tatzelbrumm/bionicblinkenlights_chipalooza/docs/RUNLOG.md

<!--
SPDX-FileCopyrightText: 2026 Christoph Maier
SPDX-License-Identifier: Apache-2.0
-->
# Run log: Bionic Blinkenlights slot for the Chipalooza sg13cmos5l harness

Cloud session, 2026-11-08 / 09 (times UTC, taken from the session transcript). Repositories: this one
(`/home/user/bionicblinkenlights_chipalooza`, branch `main`), the harness `tatzelbrumm/sg13cmos5l_ocd_chipalooza`
(read only, `/home/user/sg13cmos5l_ocd_chipalooza`), `tatzelbrumm/claude-cloud-config` (environment, read only).
Scratch work in the session scratchpad (not committed); `S` below is that scratchpad.

## Tool versions (once)

| tool | version |
|---|---|
| ngspice | ngspice-47 (`/foss/tools`, claude-cloud-config archive) |
| xschem | 3.4.8RC |
| KLayout | 0.30.12 (Debian package and Python module) |
| klayout-pex | 0.6.8 (2.5D engine) |
| magic / netgen | 8.3.685 / 1.5.324 (not used for the checks) |
| PDK | `/foss/pdks/ihp-sg13cmos5l` (IHP-Open-PDK iic-jku fork `df4c5054`), OSDI models of the archive |
| Python | 3.13 (`psutil` installed for the PDK PCell library) |

## Steps

| # | time | cwd | command / action | exit | log / output | result |
|---|---|---|---|---|---|---|
| 1 | 21:56 | `/foss` | read `/foss/setup.log` | 0 | — | setup script stopped after `APT_OK`: no `PIP_OK`, `OSDI_OK`, `CACE_OK`, `SETUP_DONE` |
| 2 | 21:57 | `/` | the missing steps of `setup-cloud.sh` by hand: OSDI copy, tool symlinks, `pip install klayout==0.30.12 klayout-pex==0.6.8`, kpex wrapper | 0 | — | tools on `PATH`; CACE not installed (not used) |
| 3 | 21:57 | harness | read `README`, `config.txt`, `gds/slot*_wrapper.gds` | 0 | — | slot 537.15 x 273 um; shared pins identical in all 18 wrappers; 2-pad slots 1, 2, 3, 6, 7, 12, 13, 16, 17, 18 |
| 4 | 21:58 | — | fetch `cmucsd.bitbucket.io` (agent, then `curl`) | fail | proxy 403 | host not in the environment's allowlist |
| 5 | 21:58 | — | environment `sg13cmos5l`: host `cmucsd.bitbucket.io` added (`update_environment`, approved) | 0 | — | — |
| 6 | 21:59 | `S/bb` | `curl` index, img7, img8, img11, img12, `spike1.asc`, PNGs | 0 | — | Q1..Q4 2N3904/2N3906, R1 330, R2 10k, R3 100k, R4 10k, R5 33k, C1 100u, C2 2u, Vdd 3 V |
| 7 | 21:59 | harness | `verilog/rtl/chipalooza_frame.v`: analog bus, bias and switch wiring | 0 | — | buses: per-slot switches to the shared pads |
| 8 | 21:59–22:01 | — | questions to Christoph; answers: generic 2-pad slot and a no-pad variant, coupling digital and analog, LED amplifier off chip, 3.3 V devices; later: self-biased minimal neurons, fast spikes fine | — | — | — |
| 9 | 22:01–22:08 | `S` | read the conventions of `sg13cmos5l_cm_slot7`, `sg13cmos5l_cm_ip__single2diff2single` (`CLAUDE.md`, `docs/traps.md`, `docs/record-keeping.md`), notes branch `sudel_buecher` (`verbatim-chatlog-export.md`, `chatlog_tools/`); skill `xschem-analog-schematic` loaded | 0 | — | record keeping and LVS conventions taken over |
| 10 | 22:07 | `S/sim` | ngspice: HV Vgs = 0 leakage, gate capacitance | 0 | — | 3..60 fA/um (L 10..0.45 um); 4.4 fF/um2 in inversion |
| 11 | 22:11 | `S/sim/n1` | neuron v0 (bias-current stand-ins) | 0 | `neuron_v0.sp` | oscillates, 7 Hz; spike < 1 ms |
| 12 | 22:14 | `S/sim/n1` | neuron v1 (slow node from a 1 nA bias) | 0 | `v1.png` | latches: slow node stuck at 3.25 V |
| 13 | 22:15 | `S/sim/n1` | `dc_dev.py`: subthreshold mirror ratios vs W, L | 0 | — | NMOS 0.8..1.8x, PMOS 0.9..2.4x of the W/L ratio; v1 resized: 2.3 Hz/nA, spike 8 ms |
| 14 | 22:18 | `S/sim/n1` | `tbb.py`: beta-multiplier reference, start-up, enable | 0 | — | starts from leakage in 9 ms; disabled 2 pA |
| 15 | 22:19–22:21 | `testbenches/ngspice` | first `bbl.spice`; `t_first.py` | 0 | `out/first.*` | all four fire; static 117 nA |
| 16 | 22:22–22:26 | `S/sim/n1` | minimal neuron: R1, R5 PMOS gate on vss, R2 NMOS gate on vdd, R4 merged into M3, only R3 biased | 0 | `run4.py`, `v4_zoom.png` | 1.72 Hz/nA, spike 5 us; 20 pF on the membrane halves f |
| 17 | 22:27 | repo | `bbl.spice` rewritten (minimal neuron, DAC, gap junctions, pulse synapses, bias) | — | — | — |
| 18 | 22:28–22:29 | `layout/scripts` | PDK PCells in the KLayout Python module (`pdk.py`: `pya` shim, `psutil`) | 0 | — | `SG13_dev`: nmosHV, pmosHV, rhigh, ptap1, ntap1, ... |
| 19 | 22:30–22:39 | `testbenches/ngspice` | tuning runs; "timestep too small"; stale `.dat` reread (fixed: outputs deleted before each run); `uic` replaced by a 100 us supply ramp | abort | `out/tune_*.log` | — |
| 20 | 22:31–22:58 | `testbenches/ngspice` | option matrices (reltol, gmin, trtol, itl4, rshunt, method), bisection by subcircuit | mixed | `S/tb_debug/` | the pulse synapses (floating nodes kicked by out) trigger the aborts |
| 21 | 22:37 | `testbenches/ngspice` | synapse internal nodes during a spike | 0 | — | floating synapse node bootstraps to 4.4 V and kicks the presynaptic out: real design flaw |
| 22 | 23:04 | repo | synapse rewritten (3.3 V NAND of spk and en drives one long PMOS into the membrane); 2.2 pF on vcpla, vcplb | 0 | `out/bis2_*` | full core converges at 0.1 ms steps |
| 23 | 23:07–23:10 | repo | layout-friendly sizing (ng instead of m, DAC on a 2.5 nA reference, C1 10 pF, rhigh meander) | — | — | — |
| 24 | 23:09–23:20 | `testbenches/ngspice` | leak resistors, cshunt, 10 us steps | mixed | — | only a 10 us max step converges (10 min per 3 s) |
| 25 | 23:11–23:17 | repo | `lay.py`, `build.py`; DRC per cell (`verification/drc/run_drc_cells.sh`) | 0 | `S/drc_*` | first run: off-grid taps, M1.d, M3.d; after fixes all 9 cells 0 violations |
| 26 | 23:19–23:20 | repo | LVS `bbl_unit` (`run_lvs.py --run_mode=deep`); `mkcdl.py` (X -> M/R); `--disable_tap_extraction` | fail, 0 | `S/lvs_unit` | vdd/vss short (rail stubs at the same x) fixed; schematic not read as X lines (CDL needed); then match |
| 27 | 23:21–23:27 | repo | `build_slot.py` (frame `slot1_wrapper.gds`, trunk band, Metal4 columns, TopMetal1 straps); LVS both slots | fail, 0 | `S/lvs_*` | rhigh `l` (41.055 um) and `ps` (0.18 um) to the CDL; then both match |
| 28 | 23:27 | repo | DRC both slots | 0 | `S/drc_slot` | 0 violations, 0 exceptions |
| 29 | 23:28 | repo | branch `main` created, commit `6c9a972`, `git push -u origin main` | 0 | — | — |
| 30 | 23:29–23:31 | repo | kpex 2.5D (`--mode CC`) both slots | 0 | `netlist/pex/` | about 2250 coupling capacitors each, 1 min per slot |
| 31 | 23:36–23:41 | `schematic/xschem` | `gen_sheets.py`, `check_sheets.py` (xschem netlist vs source, device by device) | 0 | `netlist_check/` | stub collisions and a bias short found and fixed (vertical occupancy routing); 0 mismatches in 11 sheets; testbench sheet |
| 32 | 23:39–23:46 | `testbenches/ngspice` | campaign: aborts at the reset of a bus-coupled neuron | abort | `out/sch/*.log` | minimal repro (one neuron + pass gate + bus) runs clean |
| 33 | 23:46 | repo | `build_slot.py <harness>/gds <out> 18 pads`, `mkcdl.py --slot 18 pads`, LVS | 0 | `S/slotN` | slot_18 match |
| 34 | 23:49 | `testbenches/ngspice` | internal nodes during a spike of N0 | 0 | — | N1 jumps 0.07 -> 1.6 V in one 90 ns step: spurious solution of the regenerative loop |
| 35 | 23:51 | repo | commit `941e790` (sheets, PEX, slot_N), push | 0 | — | — |
| 36 | 23:51–00:10 | `testbenches/ngspice` | trtol, reltol, 2 us steps, bias decoupling, removal of coupling blocks | 0 | `S/tb_debug/` | with the gap junctions removed the rates are the uncoupled ones; disabled gap junctions (fA) "couple" numerically |
| 37 | 00:10–00:14 | `testbenches/ngspice` | XM3 current-limited (0.3/4 um, R4 back), C2 2.6 pF | 0 | `out/m3*` | N1/N0 1.117 (expected 1.118), N3/N2 1.094 (1.095); bus pulse 2.4 V |
| 38 | 00:18 | repo | netlist and layout updated, layouts rebuilt; LVS both slots; sheets regenerated and checked | 0 | — | match, match; 0 mismatches |
| 39 | 00:18–00:22 | repo | final DRC both slots; kpex both slots | 0 | — | 0 / 0 violations, 0 exceptions; 2245 / 2253 capacitors |
| 40 | 00:18 | `testbenches/ngspice` | `campaign.py --tag sch --jobs 3` (29 cases) | — | `out/sch/` | first results consistent (tuning, 3 / 10 pF bus load) |
| 41 | 00:22 | `testbenches/ngspice` | `campaign.py --include netlist/pex/bbl_slot_pads.pex.spice --tag pex --jobs 1 --tstop 1.5` (12 cases) | — | `out/pex/` | tune_0_1_2_3: 1.52, 2.06, 2.98 Hz (schematic 1.58, 2.14, 3.07) |
| 42 | 00:24 | repo | commit `52a174b` (current-limited M3, reports, README, run log), push | 0 | — | — |
| 43 | 00:44 | `testbenches/ngspice` | busload_30p: N2, N3 stuck at vm 0.7 V, out 2.5 V | — | `out/sch/busload_30p.dat` | with the current-limited M3 the upstroke is slow, and the reset path (slow follows out) engages at the same out level: a stable intermediate state. Both campaigns stopped |
| 44 | 00:45–00:50 | `S/sim/n1` | `run7.py`: M4, R2 sizes vs bus load 3 / 33 / 103 pF | 0 | — | strong R2: no stuck state but incomplete resets (f does not scale with C); no size fixes it |
| 45 | 00:50 | `S/sim/n1` | `run8.py`: R5 split (XMR5A nmos 0.3/100 gate vdd: fast discharge; XMR5B pmos 0.3/4 gate vin: slow recharge = refractory time) | 0 | — | complete resets at every load; 10 nA: 21.25 / 6.48 / 2.47 Hz for 3 / 33 / 103 pF (1/C prediction 6.42, 2.44) |
| 46 | 00:52 | repo | netlist, layout, sheets updated; slots rebuilt; LVS both; `check_sheets.py` | 0 | — | match, match; 0 mismatches |
| 47 | 00:53 | `testbenches/ngspice` | `campaign.py --tag sch --jobs 3` (30 cases, with tune_low 5 s) | — | `out/sch/` | see SUMMARY |
| 48 | 00:54 | repo | final DRC and kpex both slots, then the post-layout campaign (12 cases, 1.5 s) | — | `verification/`, `out/pex/` | see SUMMARY |
| 49 | 01:00 | repo | commit `746af5a` (R5 split, final DRC/LVS/PEX), push | 0 | — | — |
| 50 | 01:03 | `schematic/xschem` | agent started (Christoph's question): hand-redraw of the leaf sheets with the skill `xschem-analog-schematic`, checks `check_sheets.py` and `sheet_equiv.py` | — | — | see below |
| 51 | 01:18 | `testbenches/ngspice` | campaign results (9 cases): code 1..13 1.56..15.49 Hz unloaded; code 0 fires every 3 s (0.3 Hz); code 15 about 18 Hz | — | `out/sch/` | below the 1..20 Hz spec at both ends |
| 52 | 01:19 | repo | recalibration: XMLP 0.3/8 -> 0.3/7 (DAC reference +14 %), XMH 0.3/9 -> 0.3/3.2 (base leg 0.75 unit); layouts rebuilt; LVS both | 0 | — | match, match; campaigns restarted (`--tag sch --jobs 3`; DRC, kpex, then `--tag pex`) |
| 53 | 01:03–01:37 | `schematic/xschem` | agent (step 50) done: `bbl_neuron` (laid out like spike1.asc, original part names tagged), `bbl_syn`, `bbl_bias`, `bbl_dac`, `bbl_gap` redrawn by hand; `check_sheets.py` OK for all 11 sheets; `sheet_equiv.py` (Christoph's) equivalent for all 10 compared sheets once the reference carries the two new sizes of step 52; placement scripts in `S/hand/` (not committed); `gen_sheets.py` now skips the hand-drawn sheets | 0 | `S/sheets_ref`, `S/sheets_ref_sized` | renders in `schematic/png/` |
| 54 | 01:40 | — | Christoph away; the remaining steps run unattended in `S/finish.sh` (one approval): wait for the campaigns, plots, sheet check, chat log, commits and pushes every 2 min | — | `S/finish.log` | — |
| 55 | 01:47–01:58 | — | approval prompts: the session has no Bash allow rules (only `Skill`, from the launcher); cloud sessions do not read `~/.claude/settings.json`, and a repo's `.claude/settings.json` only in a session with one repository; prompts came from commands with variables, loops and multi-line quoted messages. `S/finish.sh` stopped; from here on single-line literal commands, commit messages from a file (`git -C <repo> commit -F`) | 0 | — | commit and push ran without a prompt; the campaigns kept running |
| 56 | 01:59 | repo | `check_sheets.py` | 0 | `testbenches/ngspice/results/check_sheets.txt` | 11 sheets, 0 mismatches |
| 57 | 02:00 | `verification/pex` | kpex's built-in LVS reports "Netlists don't match": it extracts the taps as devices (layout 451, schematic 68). The PDK LVS with `--disable_tap_extraction` matches both slots. The extracted netlists keep the taps as `ntap1`/`ptap1` subcircuits, defined in the PDK's `resistors_mod.lib` | — | `netlist/pex/` | open point |
| 58 | 02:00 | `testbenches/ngspice` | post-layout `tune_0_1_2_3`: N0 (code 0) fires once, at 0.875 s, within the 1.5 s run, so no frequency (reported 0); N1..N3 2.50 / 2.95 / 3.98 Hz, 3..4 % below the schematic (2.60 / 3.06 / 4.12) | — | `out/pex/` | the 1.5 s post-layout runs resolve 1.3 Hz and up |
| 59 | 02:02–02:05 | — | both campaigns stopped: they ran detached from any tracked task; with the finish script and the watchers stopped, the idle session's container was restarted and the processes were lost (11 / 30 schematic and 3 / 12 post-layout cases had finished; their results are kept) | — | — | noticed at 03:20 |
| 60 | 03:21 | `testbenches/ngspice` | the 28 remaining cases restarted as three tracked background tasks (2 h limit each): post-layout 9 cases `--jobs 2`; schematic 7 + 7 cases `--jobs 1` each; the last 5 (`gap_both_v0.6`, `gap_both_v0.9`, `mutual_*`) follow | — | `out/sch/`, `out/pex/` | logs appended |
| 61 | 04:10–04:43 | `testbenches/ngspice` | all cases done: schematic 30, post-layout 12 | 0 | `out/sch/`, `out/pex/` | — |
| 62 | 04:45–04:58 | `testbenches/ngspice` | post-layout `busload_30p`, `busload_100p`: N2, N3 reported 0 Hz. The pulse of a bus-coupled membrane on a loaded bus peaks at 1.16 V (30 pF) and 0.90 V (100 pF), below the 1.5 V level the bus detector used. `bbltb.bus_spikes` now takes the fast upstroke (a step faster than 500 V/s followed by a rise of more than 0.15 V within 100 us) and drops the repeated time points of `wrdata`; `campaign.py --reanalyze` recomputes the results from the saved waveforms | 0 | `out/pex/*.json`, `out/sch/*.json`, `out/reanalyze_sch.log` | post-layout 30 pF: 2.18 Hz (schematic 2.19); all other values unchanged. Schematic: bus detector equal to the internal-node detector in every case except `vcplb` 0.0 / 0.8 / 1.2 V, where the pass gate keeps the spike off the bus (N2, N3 still slowed by the bus capacitance: 2.95 / 2.21 Hz at 0.8 / 1.2 V) |
| 63 | 04:50 | `testbenches/ngspice` | post-layout `busload_100p` and `tune_low` re-simulated for 4 s (one spike only in 1.5 s at 0.8 to 1.2 Hz) | — | `out/pex/` | below |
| 64 | 04:50–05:02 | `testbenches/ngspice` | coupling results; gap junction swept further (`gap_both_v0.3/0.4/0.5`, new cases) | 0 | `out/sch/` | pulse synapses: N0 -> N1 strong locks 2:1 (vector strength 0.89); mutual strong locks 1:1 (5.33 / 5.33 Hz, VS 1.00), mutual weak drifts (5.59 / 3.23 Hz). Gap junction N0 <-> N1 (8.0 / 10.6 Hz uncoupled): vcpla 0.3 V no effect, 0.4 V both slow (6.39 / 9.79 Hz, VS 0.31), 0.5 V and above and all digital legs: N0 suppressed. N3 -> bus2: N2 slowed (6.17 -> 2.40 -> 1.31 Hz), no locking. The membranes charge with 4..150 pA; a coupling conductance above about 0.1 nS drains more than that while the other neuron is in reset (ms), and a spike (10 us) is too short to pass charge: electrical coupling acts as inhibition |
| 65 | 05:20 | `testbenches/ngspice` | post-layout `tune_low` (4 s) | 0 | `out/pex/tune_low.json` | code 0: N0, N1 1.14 Hz, N2, N3 0.88 Hz (schematic 1.19 / 0.91) |
| 66 | 04:50–06:07 | `testbenches/ngspice` | post-layout `busload_100p` (4 s): ngspice stopped without output at 06:06, it needed 15 GB for all 2510 nodes over 4 s (7 GB available). `bbltb.run` now saves only the written vectors (`save`); 20 ms smoke test, then the 4 s run again | — | `out/pex/` | below |
| 67 | 06:08 | repo | LVS repeated on `final/gds/bbl_slot_shared.gds`, `bbl_slot_pads.gds` (sha256 equal to `layout/gds/`) | 0 | `S/lvs_final_*` | match, match |
| 68 | 06:09 | repo | chat log built and verified (`build_chatlog.py`, `verify_chatlog.py`) | 0 | `docs/chatlog/` | 166 texts, 0 missing, no reasoning windows found |
| 69 | 06:29–07:30 | `testbenches/ngspice` | post-layout `busload_100p` (4 s, only the written vectors saved) | 0 | `out/pex/busload_100p.json` | N2, N3 0.834 Hz (3 spikes, period 1.199 s; schematic 0.837 Hz); N0, N1 8.99 / 9.00 Hz |
| 70 | 07:30–07:43 | `testbenches/ngspice` | post-layout `busload_10p` (1.5 s), to complete the post-layout bus-capacitance curve | 0 | `out/pex/busload_10p.json`, `results/busload.png`, `results/results.md` | N2, N3 4.02 Hz (schematic 4.09); post-layout exponent over 3 / 13 / 33 / 103 pF: -0.98 (schematic -0.99 / -1.00) |
| 71 | 07:50 | repo | SUMMARY, README and `campaign.py` (`PEX_CASES` with `busload_10p`) updated; chat log rebuilt and verified; final commit | 0 | `docs/` | see the verify counts in the commit's chat log |
| 72 | 10:28–10:35 | repo | slot 3 assigned (Christoph): `build_slot.py <harness>/gds final/gds 3 pads`; `mkcdl.py ... --slot 3 pads`; IHP DRC and LVS on `final/gds/slot_3.gds`. The slot 3 frame has a second `vss_3v3` pin (Metal2, right edge, x 533.15..535.15, y 11.6..71.1; magic port 21 = the TopMetal1 pin; slots 3 and 12 only); in the first build it touched nothing and LVS matched only because KLayout joins equal labels. `build_slot.py` now ties such pins to the nearest ground strap (Via2 + Via3, Metal4 up, TopVia1, strap extended); generic variants rebuilt: XOR 0 against the delivered ones | 0 | `final/gds/slot_3.gds`, `verification/drc/slot_3`, `verification/lvs/slot_3` | DRC 0 violations, LVS match; label-free flood fill from the Metal2 pin reaches the TopMetal1 `vss_3v3` pin |
| 73 | 10:36–10:40 | repo | `build_slot.py` reads the pad types from the harness `config.txt` (the old list allowed slots 6, 7, 13, 17, whose dedicated pads are digital or custom, and missed 5, 9, 10, 14); `bbltb.slot_dut` maps the pins of any slot; generic variants moved out of `final/gds/` (copies in `layout/gds/`, same sha256); README: slot 3 and how to move to another slot | 0 | `layout/scripts/build_slot.py`, `testbenches/ngspice/bbltb.py`, `README.md` | slot 6 refused (pads `IOPadIn`, `IOPadOut16mA`); slot 3 rebuilt: XOR 0 against `final/gds/slot_3.gds` |
| 74 | 10:38–10:45 | `testbenches/harness_bus` | what a slot bus sees in the harness: the harness's extracted `analog_switch_med` (`netlist/layout/chipalooza_frame.spice`, read only) and the PDK `sg13cmos5l_IOPadAnalog`, AC (1 kHz) and DC at 0.3 / 0.8 / 1.5 V, 27 and 60 C. Topology from the harness RTL: per bus, 18 switches (one per slot) on one shared net that is the analog pin | 0 | `testbenches/harness_bus/results.md` | closed switch 1.7..2.4 pF; open switch 0.43 pF (slot side), 0.40 pF (shared side, x 17); pad 0.21 pF. Pad leakage (model) 106 / 187 / 336 pA to ground at 0.3 / 0.8 / 1.5 V (27 C), from the soft-breakdown term of the antenna diode models (`bv` 11.6 V, `nbv` 48.9; "designed for reverse direction"); the clamps alone source 6..27 pA |
| 75 | 10:40–11:05 | `testbenches/harness_bus` | N2, N3 with the pad on `analog_bus2/3` (bus switch closed), schematic, 2.5 s. The full pad model stops the transient at the first reset (antenna diode in forward bias, "Timestep too small"); replaced by its DC I-V as a `pwl` B source plus 0.21 pF (`padiv.py`). First try used `table` (not an ngspice function) and failed; rerun with `pwl` | 0 | `testbenches/harness_bus/padtest_leak.json`, `results.md` | no spike at codes 6 / 10 / 15 (3 pF), code 15 with 10 pF, code 15 at 60 C: membranes settle at 0.09 / 0.25 / 0.51 V, where charging current (about 62 / 97 / 139 pA) = pad leakage. Reference without pad, code 15, 10 pF: 10.46 Hz (1/C law 10.43) |
| 76 | 11:08 | repo | LVS of `slot_3` repeated against the committed `bbl.cdl` (11:02, match); README, SUMMARY; chat log rebuilt and verified; commit | 0 | `docs/` | 193 texts, 0 missing; 4 40-character windows shared with reasoning, all from one sentence of a visible reply (pad leakage "0.1–0.3 nA at 0.3–1.5 V, comparable to or larger than the 4–150 pA that charges the membranes"), no reasoning text in the log |
| 77 | 11:10–11:20 | `S/n3hi` | Christoph: option 2 for N3, "and tolerate that the design makes itself heard (frequency shift to audio range, with the option to detune to blinking frequencies by loading the analog bus with external capacitance)". Trial a: N3 = `bbl_neuron_hi` with XMR3 48/3 x 8 (16 x the DAC current: 5.6 .. 174 nA), XMR5B, XM2 and the pass gate XMP3 scaled | 0 | `S/n3hi/n3a.json` | 3 pF: 674 Hz / 5.5 kHz / 12.7 kHz at codes 0 / 6 / 15; 20 pF with the pad leakage: -2.4 %. 10 nF: no oscillation (membrane held at 0.78 V, 10 uA): with nF on the membrane the regenerative loop through it (XM3) is 1000 x slower than the reset, which then holds the membrane at the threshold |
| 78 | 11:20–11:50 | `S/n3hi` | hysteresis for N3, probed on the internal nodes (`probe.py`): b, c PMOS pull-up on out with gate rst (turns off only at rst about 2.5 V, after XM2 has started the reset); e NMOS pull-up with gate slow; f Schmitt comparator (inverter out -> outb, pull-up XMQ gate outb) with the inverter switching at 1.5 V (too late); g inverter skewed to 2.3 V: flips cleanly, 1 nF resets fully, 10 nF only to 0.63 V (slow recharged through the XMR5A follower within 1 us, rst collapsed); h XMR5A 0.3/100: reset cut short when the internal membrane falls below the release level before the bus | — | `S/n3hi/` | i (below) |
| 79 | 11:50–12:05 | `S/n3hi` | variant i: XMR5A becomes a switch slow -> vss with gate outb (3/0.45): slow empties within ns when out falls and recovers only through XMR5B (10/0.45 x 2), rst fully high for the whole refractory time; XM4 10/0.45, XM2 40/0.45, XMP3 40/0.45, Schmitt XMQ 0.3/3, XMIP 3/0.45, XMIN 0.3/4. N3 spikes counted from membrane resets (out only dips for ns) | 0 | `S/n3hi/` | 3 pF: 470 Hz / 3.88 kHz / 8.92 kHz (codes 0 / 6 / 15, CV < 0.4 %); 100 pF code 6: 500 Hz; 1 nF: 55.0 Hz; 10 nF: 0.67 / 5.56 / 12.84 Hz; pad leakage: 20 pF code 0 209 Hz, 10 nF code 6 5.54 Hz (-0.25 %); bus swings 0 .. 0.92 V and resets fully in every case. Harness switch closed: 3.5 .. 17 Ohm (`ron.sp`) |
| 80 | 11:12–12:08 | `layout/`, `schematic/` | `build.py`: `bbl_unit_hi` (sizes table, Schmitt devices, XMR5A terminals), XMP3 40/0.45; stub rule: same-net Metal2 stubs closer than 0.45 um and not coincident gave M2.b / V2.b / V2.a in `bbl_unit_hi`, now kept apart (all other cells XOR 0 against the old ones); `bbl_pass` wider, `bbl_lvinv` / `bbl_tielo` moved 5 um right. `gen_sheets.py`: `bbl_neuron_hi.sch` derived from the hand-drawn `bbl_neuron.sch` (sizes from the netlist, XMR5A rewired, Schmitt devices added on the right), `bbl_unit_hi`; renders | 0 | `layout/gds/`, `final/gds/slot_3.gds`, `schematic/` | `check_sheets.py`: 13 sheets, 0 mismatches |
| 81 | 12:09–12:14 | repo | IHP DRC (no density) and LVS (`--disable_tap_extraction`) on `slot_3`, `bbl_slot_pads`, `bbl_slot_shared`; kpex 2.5D CC on all three | 0 | `verification/`, `netlist/pex/` (new `slot_3.pex.spice`) | DRC 0 / 0 / 0; LVS match x 3; 2288 / 2288 / 2280 coupling capacitors |
| 82 | 12:15 | `testbenches/ngspice` | testbench: harness switch 10 Ohm (was 2 kOhm), N3 spikes from membrane resets (`bbltb.resets`), 10 nF on `analog_bus3` in all system cases (`CBUS`), new N3 cases (`n3_tune_*`, `n3_busload_*` 3 pF .. 100 nF, `n3_blink_*`, `n3_pad_*`); old results moved to `out/*_before_n3hi`; campaigns started: schematic 51 cases `--jobs 3`, post-layout on `slot_3` 20 cases `--tstop 1.5` | — | `out/sch/`, `out/pex/` | rows 83 ff. |
| 83 | 12:15–14:12 | `testbenches/ngspice` | the two campaigns | 0 / killed | `out/sch/`, `out/pex/`, `campaign_*.log` | schematic: 49 of 51 ok; `vcplb_0.0` (at 1.15 s) and `n3_busload_100n` (at 0.97 s) stopped with "Timestep too small, trouble with node bus0", also after the retry at half the step. Post-layout: stopped by the 2 h limit of the background task after 11 of 20 cases; `n3_tune_15` stopped the same way (at 5.4 ms) |
| 84 | 14:13–14:21 | `testbenches/ngspice` | cause: the slot side of the bus switch (`bus0`, an inverter output) had only femtofarads behind 10 Ohm, a time constant of femtoseconds. `bbltb.netlist`: 0.5 pF of the bus capacitance moved to the slot side (`cslot`; the closed switch has 0.45 pF of its own per side, `harness_bus`), the total unchanged. Check, schematic, tag `chk` | 0 | `out/chk/` | `n3_tune_6` 3882.30 Hz (before 3882.74), `n3_tune_15` 8922.90 (8924.50, the run that had not failed in the schematic), `n3_pad_15` 4070.40 (4070.21): at most 0.02 %, so the other results stand. Reruns started: schematic `n3_busload_100n`; post-layout the 9 remaining cases and `n3_tune_15` in two tasks (`--jobs 2`, `--jobs 1`) |
| 85 | 14:13–14:20 | `S`, `out/sch/` | `bus23_weak`: N3 does not fire. Waveforms 1.0 .. 1.1 s | 0 | — | bus3 0.48 .. 0.66 V, bus2 0 .. 2.05 V, N2 33 Hz: the weak leg (0.3/10, about 0.1 MOhm) passes N3's 80 nA (code 7) to bus2, N2 (threshold about 0.66 V) fires first and its resets drain N3 (threshold 0.92 V). The strong leg locks both 1:1 at 8.81 Hz. `vcplb_0.0` (partial waveform, 1.15 s): N3 599 Hz on its own membrane. The 9.32 Hz first read for it came from the old campaign's lines at the top of the appended log |
| 86 | 14:21–14:31 | `S/n3hi` (`iq.py`, `icharge.py`, `idac.py`) | DC sweeps with the membrane held by a source: supply current vs membrane voltage, charging current vs code, DAC diode current (the DAC's vdd pin on its own ammeter). An `op` lands in the reset state (mA into the source); a `dc` sweep from 0.1 V continues on the right branch | 0 | — | N3 charges with 6.06 nA at code 0, 7.44 nA more per step, 117.7 nA at code 15 (not 5.6 .. 174 nA as written since row 77: 15.9 x the DAC's 0.383 .. 7.42 nA); N2 7.7 .. 139 pA (DAC / 50 .. 53, not 1/57). Supply current above the bias: N2 0.2 uA at 0.6 V, 1.2 uA at 0.7 V, then fires; N3 1.2 uA at 0.7 V, 7.2 uA at 0.9 V (the Schmitt trigger holds out up to 0.92 V): the slot's 0.85 .. 1.6 uA in the campaign. Refractory time of N3 from the waveforms (membrane below 20 mV): 190 / 23 / 11 us at codes 0 / 6 / 15, a tenth of the period on the bare bus (README had 0.8 ms .. 8 us) |
| 87 | 14:22–14:28 | `testbenches/ngspice` | cases `n3_c20p_0`, `n3_c20p_15` (20 pF on bus3, no pad), the references for `n3_pad_*` | 0 | `out/sch/` | 214.85 / 4101.45 Hz; with the pad 209.21 / 4070.21 Hz: -2.6 % / -0.76 % |
| 88 | 14:24–14:32 | repo | corrections from rows 85 to 87 in README, `harness_bus/results.md` (N2's threshold about 0.7 V, where the pad sinks 170 pA; "1.6 V" was wrong), comments of `bbl.spice` (N3 currents and refractory time, DAC), sheet note of `bbl_neuron_hi` (XMR5A gate on outb); `gen_sheets.py`, `check_sheets.py`, render; `bbl.cdl` regenerated (diff: comments only) | 0 | `schematic/`, `netlist/` | 13 sheets, 0 mismatches. The README's 10 MOhm probe sentence was wrong (50 nA at 0.5 V, "stops N3 below code 5"): the probe sinks 92 nA at the 0.92 V threshold and stops N3 up to code 11 |
| 89 | 14:32–14:36 | `testbenches/ngspice` | load average 16 to 20 with 4 to 7 ngspice: 8 threads each. `OMP_NUM_THREADS=1` in the testbench environment leaves them at 8 (reverted); the helper threads do work (about 42 s CPU each against 4.3 min for the main thread). The 4 s post-layout `busload_100p` stopped again to keep the other tasks within their 2 h; `bbltb.run` now keeps a failed attempt's log as `.log1` | — | — | — |
| 90 | 14:38–15:06 | `testbenches/ngspice` | the reruns with 0.5 pF on the slot side. `vcplb_0.0` stopped at bus3 (0.25 s) and bus2 (0.049 s); with 2 kOhm and femtofarads (the old model) at bus2 (1.09 s, 0.33 s): with the pass gates off the slot side of the bus floats. `n3_busload_100n` stopped at bus0 (9.1 s); post-layout `busload_10p` at bus0 (0.54 s); `tune_12_13_14_15`, `syn01_both`, `busload_30p`, `bus23_strong` needed retries. New bus model (`bbltb.netlist` defaults): bus2 / bus3 10 Ohm with 0.5 pF on the slot side; bus0 / bus1 (buffered N0 / N1, display only) 2 kOhm with all of C on the bus side, the model of every run before 2026-11-09 (N0 / N1 rates with either: 9.3207 / 9.3192 Hz at code 6, 1.18578 / 1.18575 Hz at code 0). `vcplb_0.0`: 2 kOhm and 0.5 pF on every bus, 1.2 s. The old-model retries of `busload_30p` and `bus23_strong` killed and rerun with the new one | 0 | `out/sch/n3_busload_100n.*` | `n3_busload_100n` (2 kOhm on bus0 / bus1): N3 0.6415 Hz, 15 % above the 1/C line through 10 nF (0.556 Hz): the bus resets only to 0.11 V, because the refractory time (23 us at code 6) is two time constants of 100 nF through about 110 Ohm (pass gate, reset transistor, switch). The README had "resets completely from 3 pF to 100 nF" (also in the message of commit `252bc48`): true up to 10 nF |
| 91 | 15:05–15:28 | `testbenches/ngspice` | more stops with the new bus model: post-layout `busload_10p` at 0.5417 s (with 10 Ohm on bus0 at 0.5415 s: the same instant, one of N3's resets, 0.1819 + 2 x 0.17997 s), so the bus model is not the cause; `vcplb_0.0` with `.option itl4=100` at 0.106 s and 0.493 s. `bbltb.run` keeps the first attempt's waveforms too (`.dat1`); `campaign.py`: when both attempts stop, the rates come from the longer one if it covers at least half of t0 .. tstop (`partial` = where it ends, in the JSON); `--reanalyze` does the same with saved waveforms | 0 | `out/sch/vcplb_0.0.json` | `vcplb_0.0` reanalyzed (partial, 0.1 .. 0.493 s): N0 / N1 / N2 9.32 / 9.34 / 9.33 Hz (N2 on its own membrane), N3 599.2 Hz. Post-layout done: `tune_12_13_14_15`, `syn01_both`, `bus23_off`, `bus23_strong` (8.74 / 8.74 Hz), `n3_tune_15` (8689 Hz), `busload_30p` |
| 92 | 15:15–15:25 | `testbenches/ngspice` | spike intervals of every free-running neuron in every result, flagged where one differs from the median by more than 5 % | 0 | — | 5 spurious early spikes in about 75 runs: post-layout `busload_0p` N0 and N1 together at 1.2953 s (76 ms into a 110 ms ramp; mean rate 9.32 Hz against 9.02 Hz from the median interval), schematic `tune_8_9_10_11` N0 (2.3452 s), `n3_busload_100n` N0 (9.2129 s), `syn01_none` N1 (2.2737 s); plus a short first interval after t0 in `n3_c20p_15` / `n3_pad_15` (start-up, both alike). `plots.py`: rates of free-running neurons (tuning, bus load, N3 tables and figures) = 1 / median interval; the coupling cases keep the mean rate |
| 93 | 15:26–15:27 | repo | IHP LVS (deep, `--disable_tap_extraction`) of `slot_3`, `bbl_slot_pads`, `bbl_slot_shared` against the regenerated `bbl.cdl`; the 12:10 run logs removed (the other files of those directories were overwritten) | 0 | `verification/lvs/` | match x 3, 0 errors |
| 94 | 15:28–15:54 | `testbenches/ngspice`, `S/slot3` | post-layout `busload_10p` stopped in both attempts (retry at 1.219 s): reanalyzed as partial (0.3 .. 1.219 s); `gap_off`, `gap_both` done. XOR of `slot_3` against `bbl_slot_pads` repeated on the current layouts (`xor_slot.py`) | 0 | `out/pex/` | N2 4.01 Hz at 13 pF (schematic 4.09); gap off 7.70 / 10.26 Hz, both legs N0 fewer than 2 spikes in 1.5 s, N1 9.08 Hz. XOR: Metal2 and its pin layer (the `vss_3v3` pin), Via2 .. TopVia1 (the via stack), 67/23 (slot 1's no-fill box), labels `s3_*` / `s1_*`, `vss_3v3`; nothing else |
| 95 | 15:56–16:02 | repo | post-layout `busload_100p` (4 s) done; `plots.py sch pex` (post-layout points without connecting lines where they are sparse); README, SUMMARY (rewritten for N3, sha256 of the delivered files), `harness_bus/results.md`; chat log rebuilt and verified; commit, push | 0 | `testbenches/ngspice/results/`, `docs/` | N2 0.833 Hz at 103 pF (schematic 0.837), post-layout exponent -0.98. Chat log: 290 texts, 0 missing; 5 40-character windows shared with reasoning, all in visible replies (the pad-leakage sentence of row 76, and "I've stopped the 4 s run and will restart it when cores free up"), no reasoning text in the log |
