tatzelbrumm/bionicblinkenlights_chipalooza/render/bbl_slot_pads.png

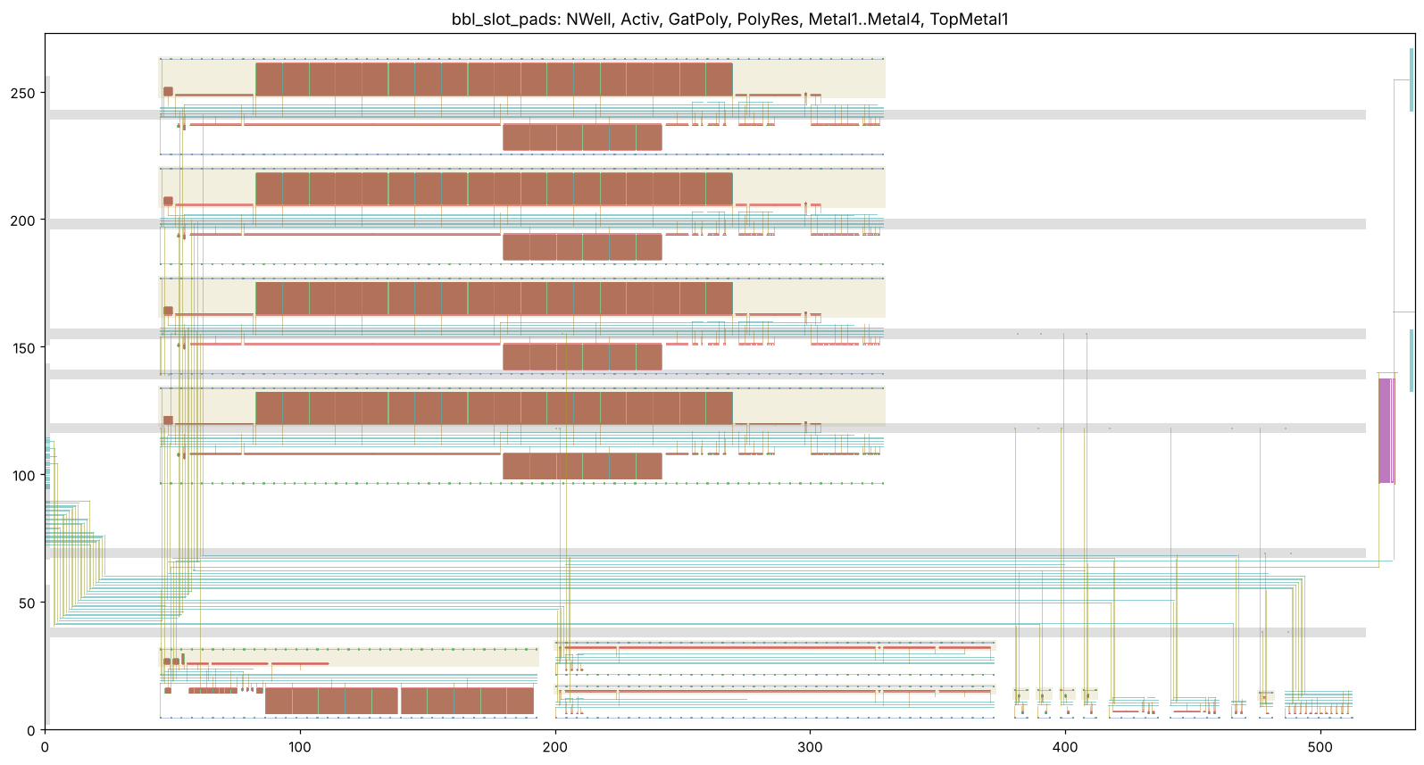
render/bbl_slot_pads.png
