tatzelbrumm/bionicblinkenlights_chipalooza/render/bbl_unit.png

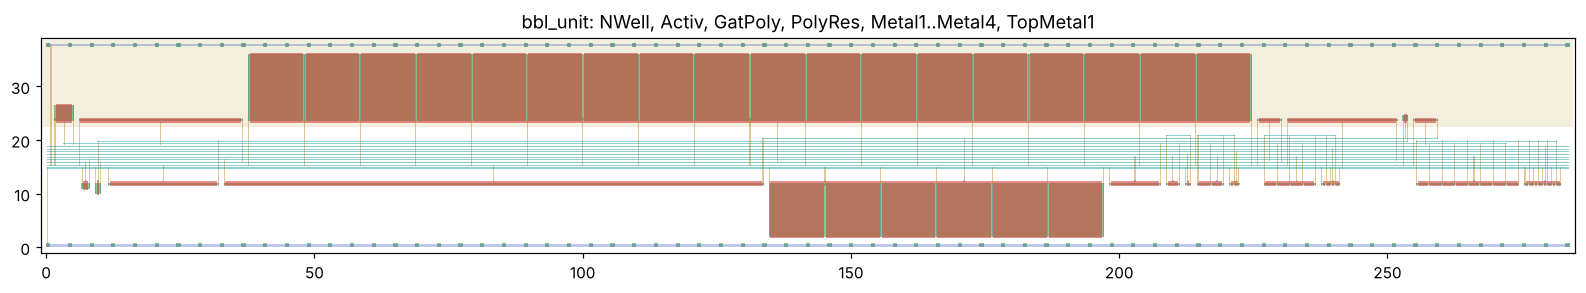
render/bbl_unit.png
