tatzelbrumm/bionicblinkenlights_chipalooza/schematic/png/bbl_bias.png

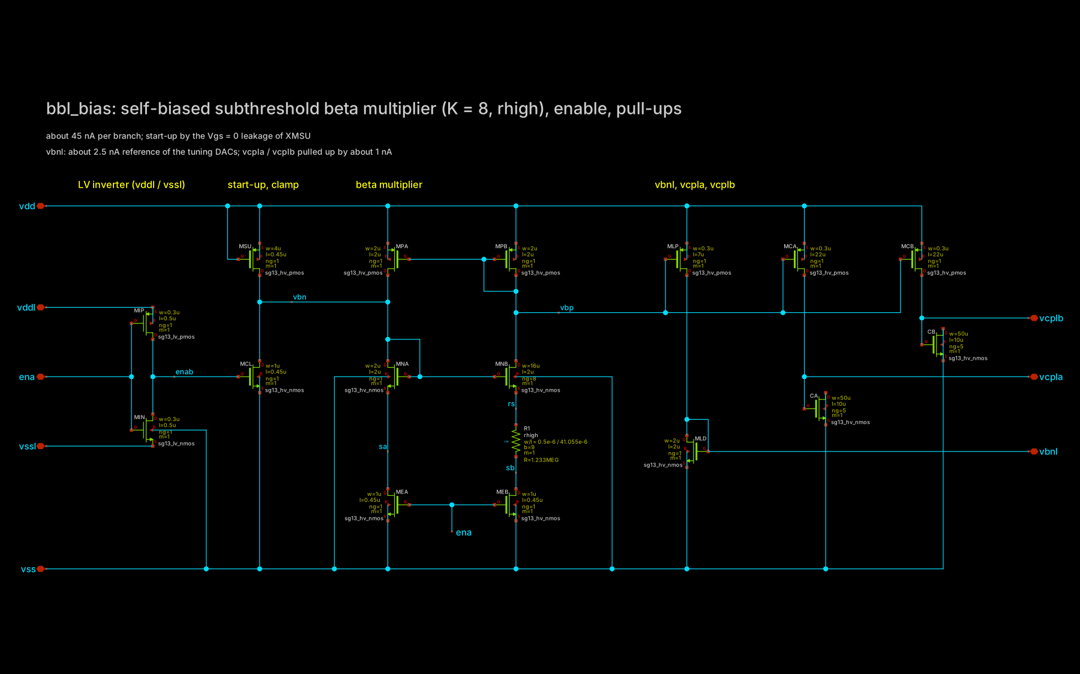
schematic/png/bbl_bias.png
