tatzelbrumm/bionicblinkenlights_chipalooza/schematic/png/bbl_core.png

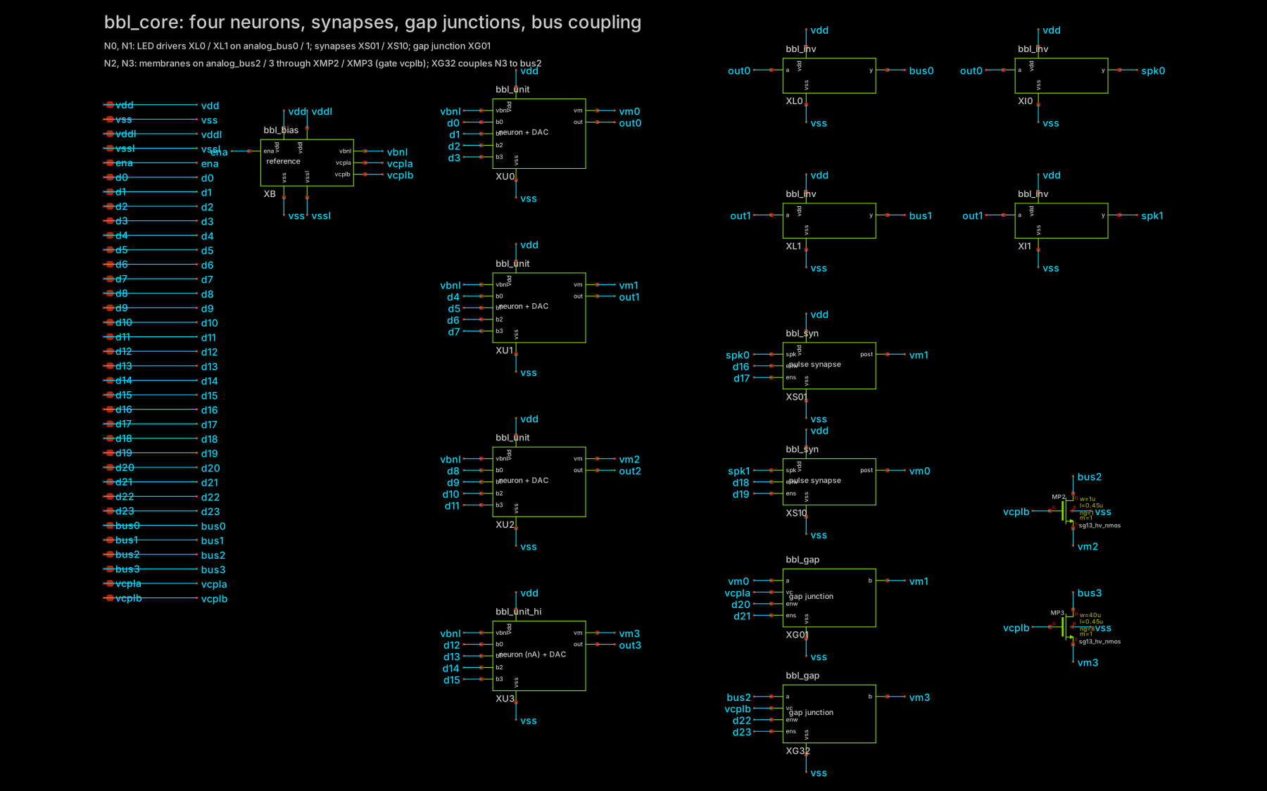
schematic/png/bbl_core.png
