tatzelbrumm/bionicblinkenlights_chipalooza/schematic/png/bbl_dac.png

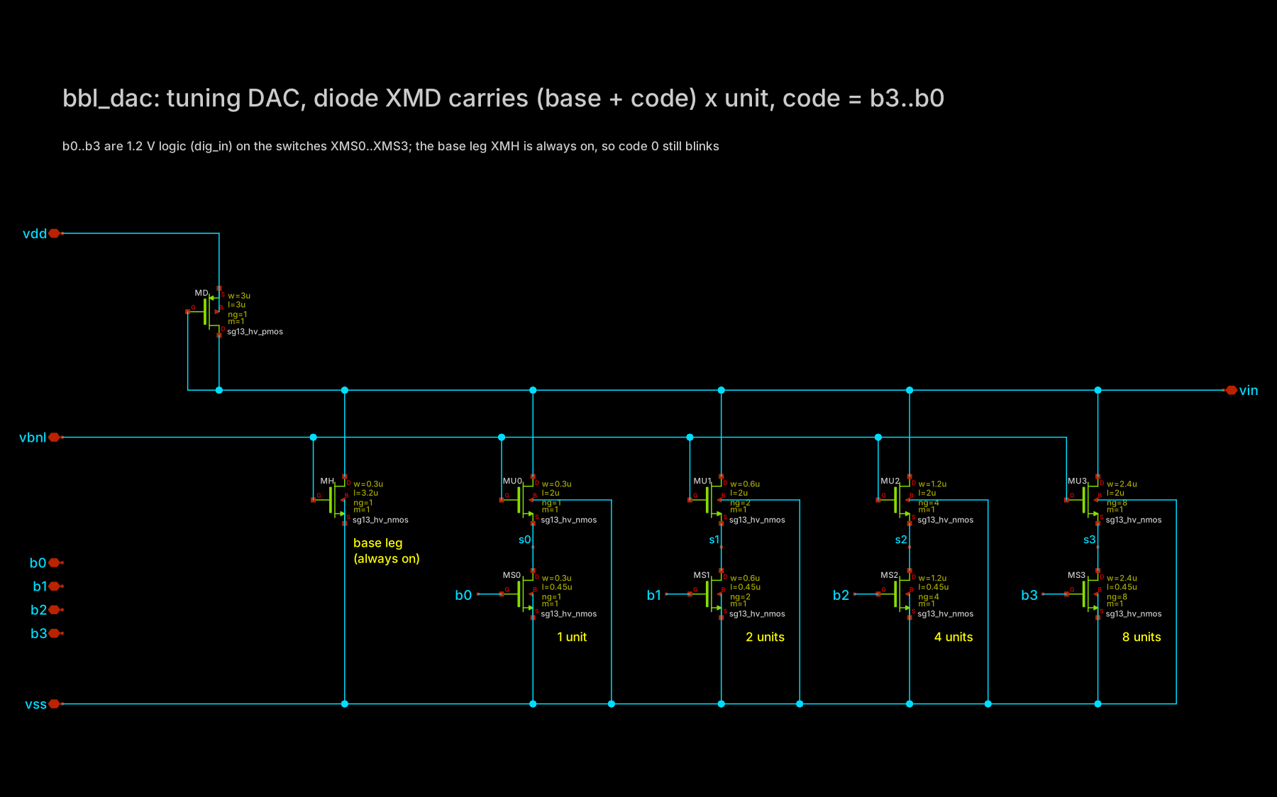
schematic/png/bbl_dac.png
