tatzelbrumm/bionicblinkenlights_chipalooza/schematic/png/bbl_gap.png

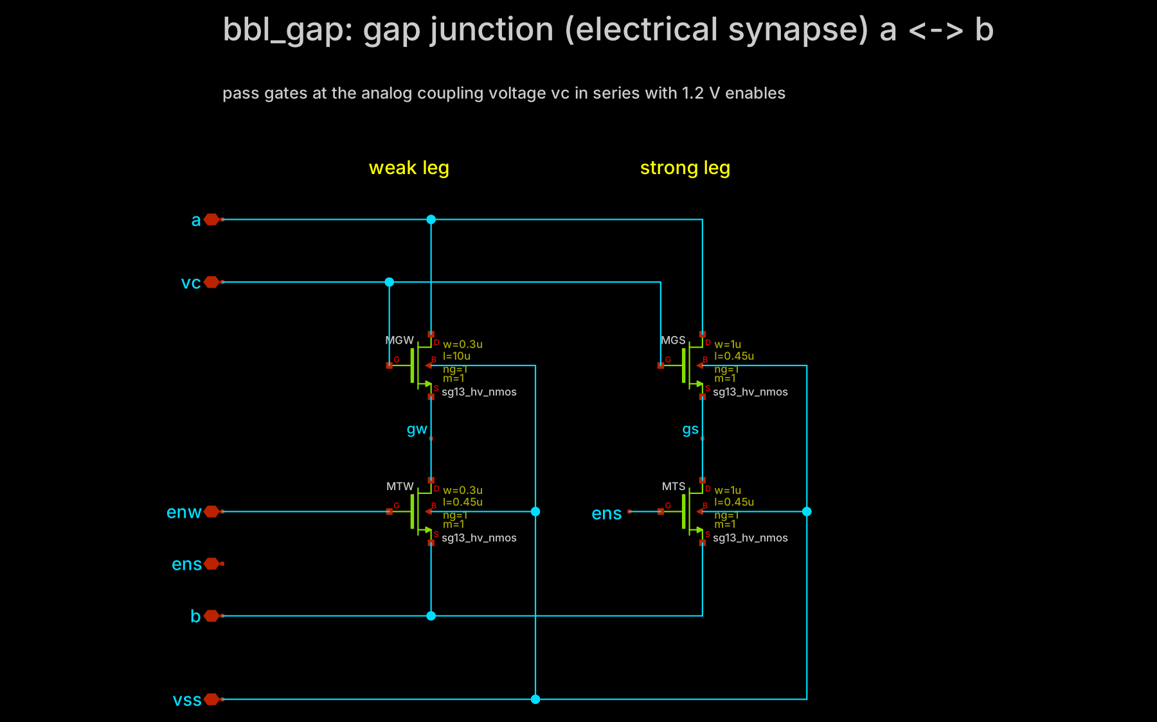
schematic/png/bbl_gap.png
