tatzelbrumm/bionicblinkenlights_chipalooza/schematic/png/bbl_inv.png

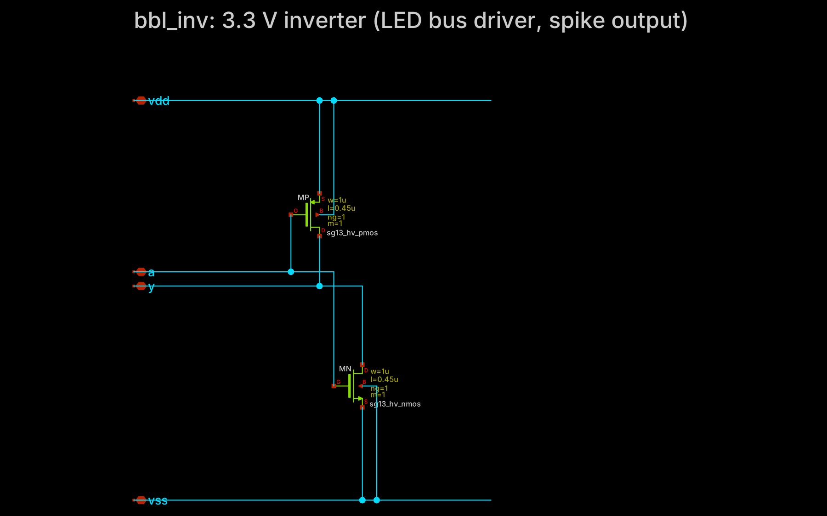
schematic/png/bbl_inv.png
