tatzelbrumm/bionicblinkenlights_chipalooza/schematic/png/bbl_neuron.png

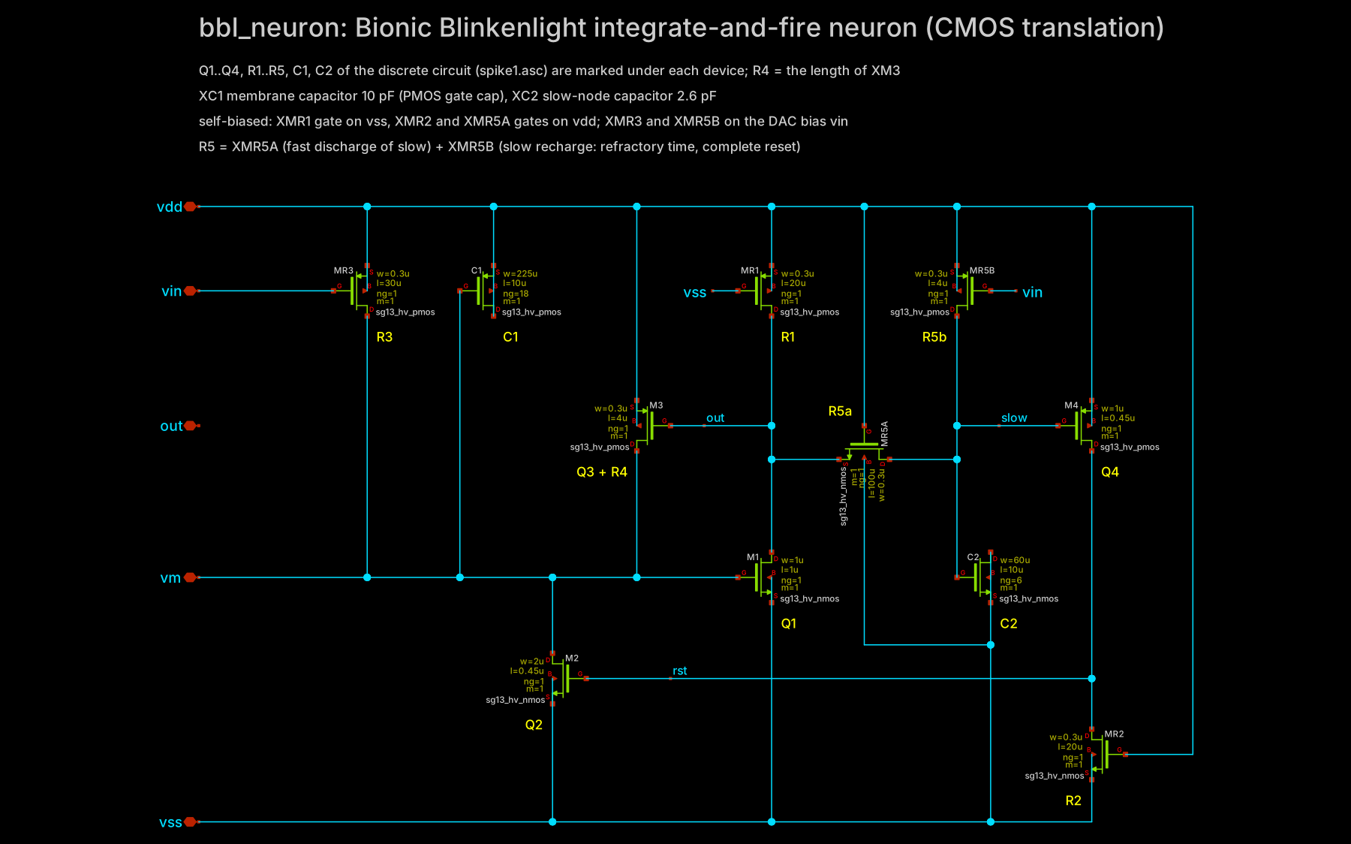
schematic/png/bbl_neuron.png
