tatzelbrumm/bionicblinkenlights_chipalooza/schematic/png/bbl_neuron_hi.png

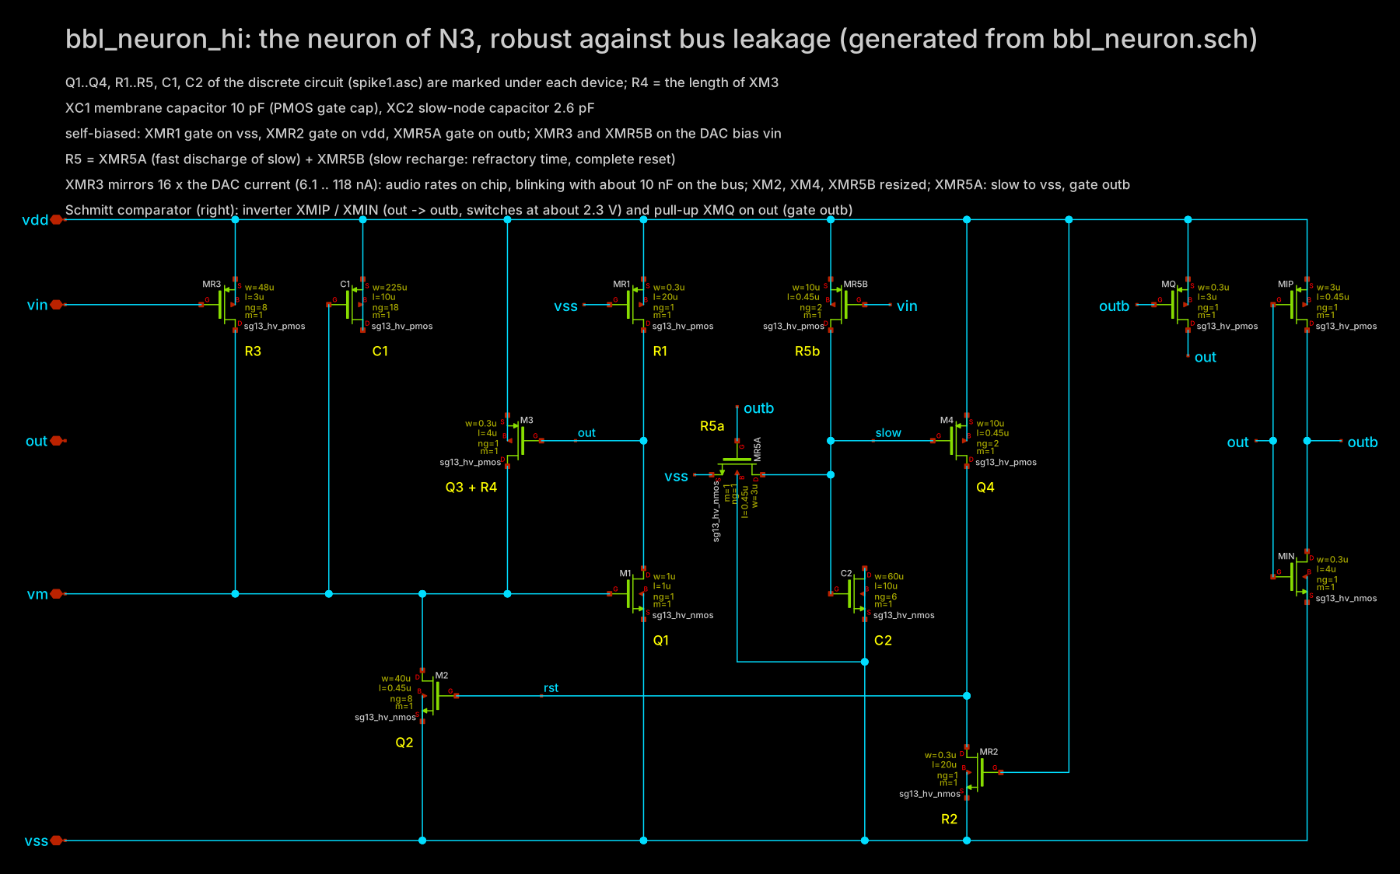
schematic/png/bbl_neuron_hi.png
