tatzelbrumm/bionicblinkenlights_chipalooza/schematic/png/bbl_slot_pads.png

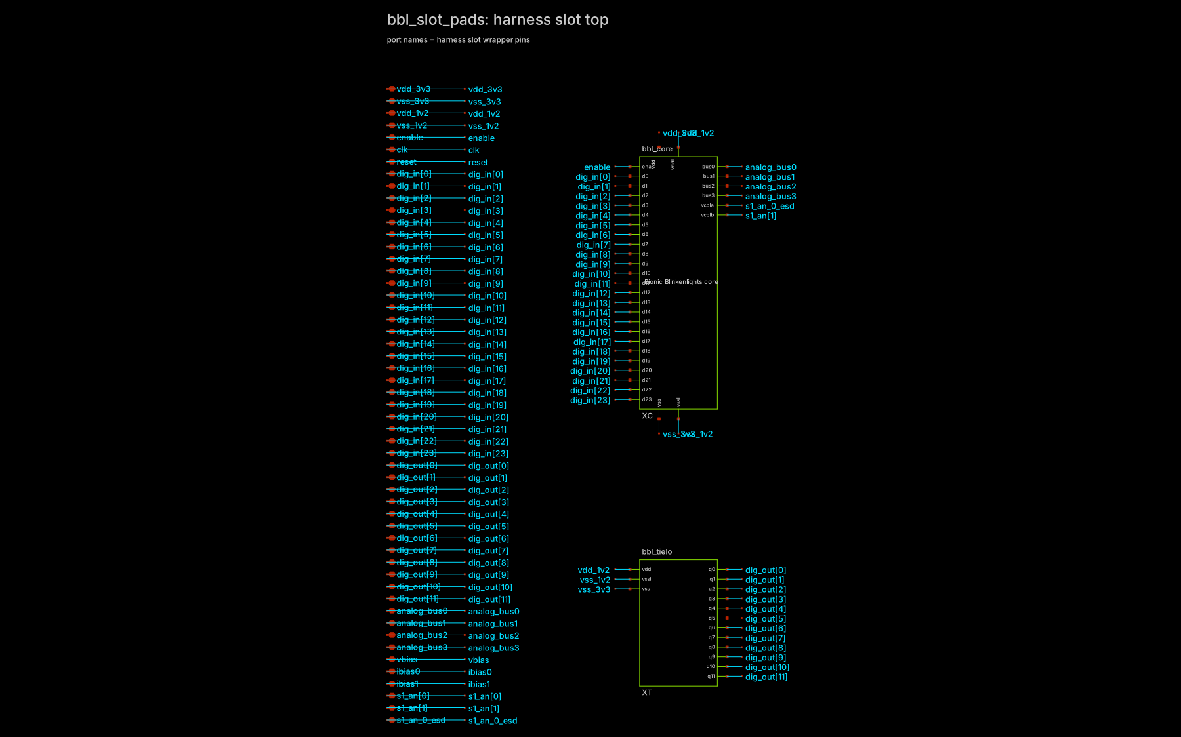
schematic/png/bbl_slot_pads.png
