tatzelbrumm/bionicblinkenlights_chipalooza/schematic/png/bbl_syn.png

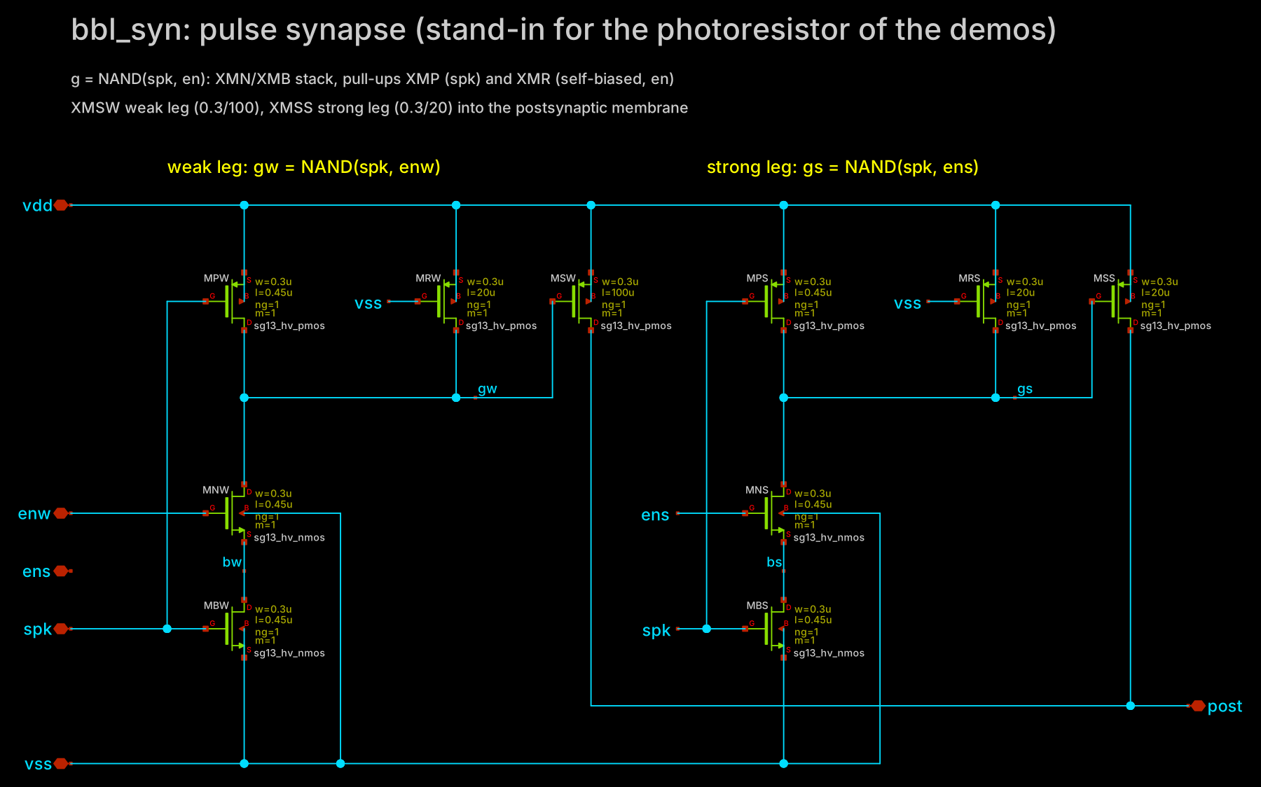
schematic/png/bbl_syn.png
