tatzelbrumm/bionicblinkenlights_chipalooza/schematic/png/bbl_tielo.png

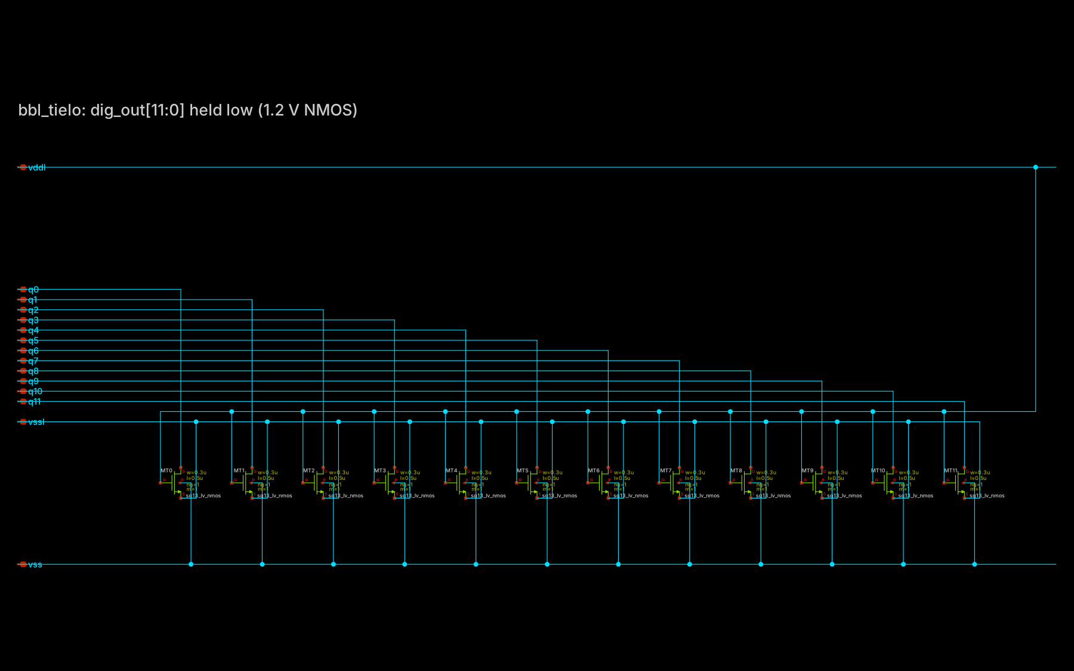
schematic/png/bbl_tielo.png
