tatzelbrumm/bionicblinkenlights_chipalooza/schematic/png/bbl_unit.png

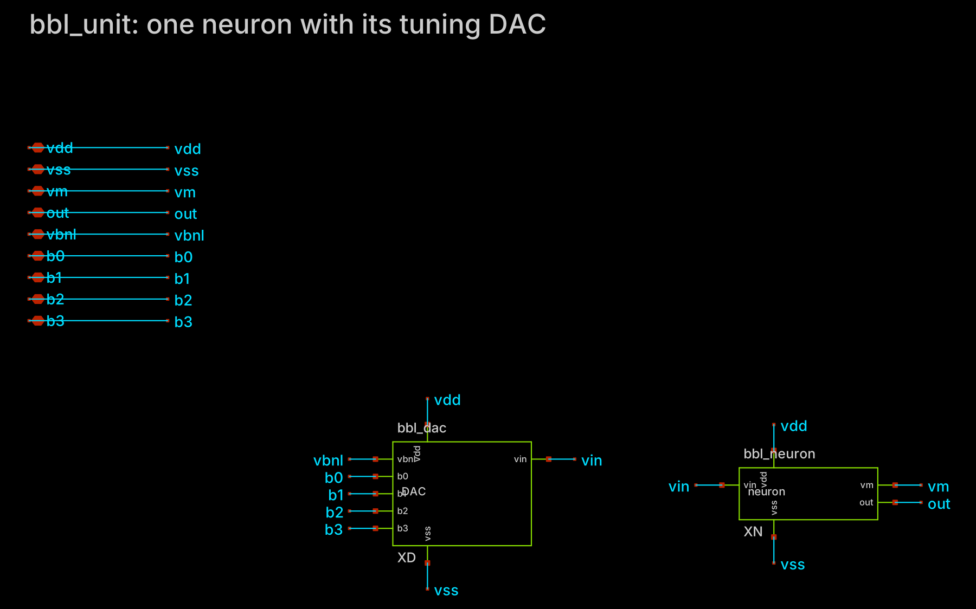
schematic/png/bbl_unit.png
