tatzelbrumm/bionicblinkenlights_chipalooza/schematic/png/bbl_unit_hi.png

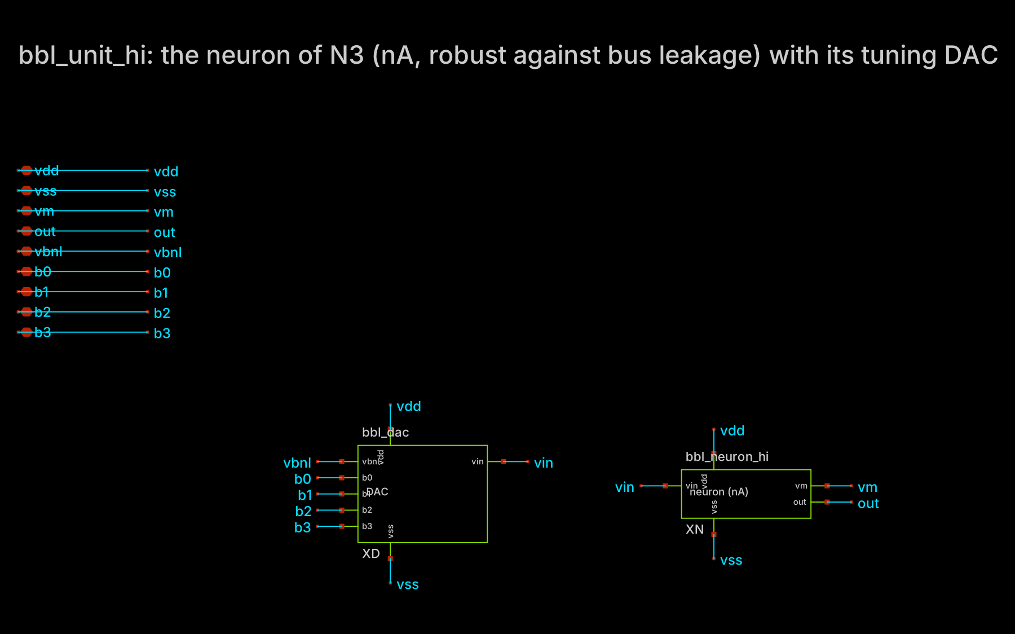
schematic/png/bbl_unit_hi.png
