tatzelbrumm/bionicblinkenlights_chipalooza/schematic/png/tb_bbl_slot_shared.png

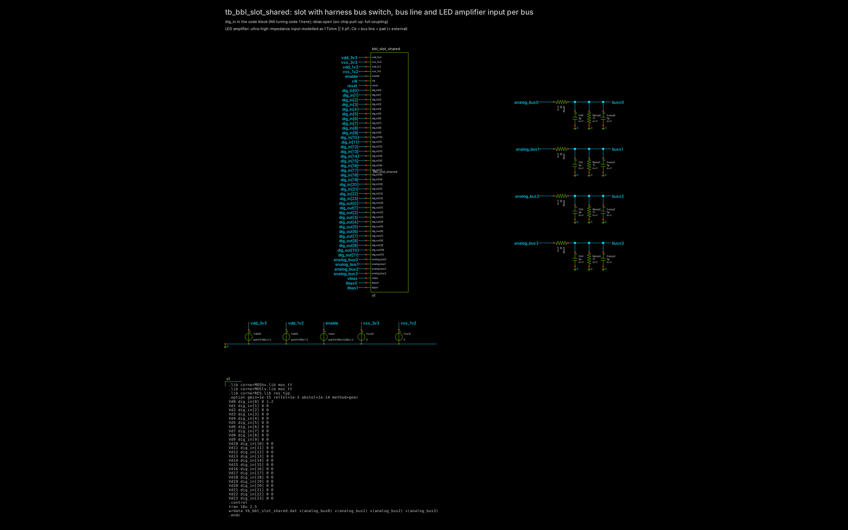
schematic/png/tb_bbl_slot_shared.png
