tatzelbrumm/bionicblinkenlights_chipalooza/testbenches/ngspice/results/results.md

| case | tag | f N0 | f N1 | f N2 | f N3 (Hz) | N0:N1 ratio | VS01 | N2:N3 ratio | VS23 | I(vdd) avg |
|---|---|---|---|---|---|---|---|---|---|---|
| bus23_off | sch | 1.19 | 1.19 | 6.18 | 6.37 | nan | nan | 1.00 | 0.77 | 1349 nA |
| bus23_strong | sch | 1.19 | 1.19 | 8.81 | 8.81 | nan | nan | 1.00 | 1.00 | 452 nA |
| bus23_strong_30p | sch | 1.19 | 1.19 | 8.78 | 8.78 | nan | nan | 1.00 | 1.00 | 465 nA |
| bus23_weak | sch | 1.19 | 1.19 | 33.02 | < 2 spikes in 2.5 s | nan | nan | nan | nan | 848 nA |
| busload_0p | sch | 9.32 | 9.34 | 7.19 | 5.56 | 1.00 | 1.00 | 1.25 | 0.08 | 1391 nA |
| busload_100p | sch | 9.32 | 9.34 | 0.84 | 5.56 | 1.00 | 1.00 | nan | nan | 1373 nA |
| busload_10p | sch | 9.32 | 9.34 | 4.09 | 5.56 | 1.00 | 1.00 | 0.75 | 0.04 | 1381 nA |
| busload_30p | sch | 9.32 | 9.34 | 2.19 | 5.56 | 1.00 | 1.00 | 0.42 | 0.02 | 1375 nA |
| gap_both | sch | 1.44 | 9.33 | 0.91 | < 2 spikes in 2.5 s | 0.14 | 0.00 | nan | nan | 922 nA |
| gap_both_v0.3 | sch | 7.90 | 10.59 | 0.91 | < 2 spikes in 2.5 s | 0.74 | 0.09 | nan | nan | 950 nA |
| gap_both_v0.4 | sch | 6.51 | 9.90 | 0.91 | < 2 spikes in 2.5 s | 0.71 | 0.32 | nan | nan | 939 nA |
| gap_both_v0.5 | sch | < 2 spikes in 2.5 s | 10.24 | 0.91 | < 2 spikes in 2.5 s | nan | nan | nan | nan | 866 nA |
| gap_both_v0.6 | sch | < 2 spikes in 2.5 s | 10.07 | 0.91 | < 2 spikes in 2.5 s | nan | nan | nan | nan | 875 nA |
| gap_both_v0.9 | sch | < 2 spikes in 2.5 s | 9.60 | 0.91 | < 2 spikes in 2.5 s | nan | nan | nan | nan | 890 nA |
| gap_off | sch | 8.00 | 10.65 | 0.91 | < 2 spikes in 2.5 s | 0.74 | 0.04 | nan | nan | 949 nA |
| gap_strong | sch | < 2 spikes in 2.5 s | 9.34 | 0.91 | < 2 spikes in 2.5 s | nan | nan | nan | nan | 917 nA |
| gap_weak | sch | 1.04 | 9.34 | 0.91 | < 2 spikes in 2.5 s | nan | nan | nan | nan | 919 nA |
| mutual_mutual_strong | sch | 5.33 | 5.33 | 0.91 | 0.67 | 1.00 | 1.00 | 1.50 | 0.44 | 1041 nA |
| mutual_mutual_weak | sch | 5.59 | 3.25 | 0.91 | 0.67 | 1.75 | 0.32 | 1.50 | 0.44 | 1056 nA |
| mutual_none | sch | 5.33 | 2.60 | 0.91 | 0.67 | 2.00 | 0.61 | 1.50 | 0.44 | 1048 nA |
| n3_blink_0 | sch | 9.32 | 9.34 | 7.19 | 0.67 | 1.00 | 0.98 | 10.25 | 0.15 | 1281 nA |
| n3_blink_15 | sch | 9.32 | 9.34 | 7.19 | 12.84 | 1.00 | 1.00 | 0.56 | 0.04 | 1480 nA |
| n3_busload_0p | sch | < 2 spikes in 0.02 s | < 2 spikes in 0.02 s | < 2 spikes in 0.02 s | 3882.74 | nan | nan | nan | nan | 1465 nA |
| n3_busload_100n | sch | 9.33 | 9.34 | 7.19 | 0.64 | 0.99 | 0.98 | 12.00 | 0.22 | 1457 nA |
| n3_busload_100p | sch | < 2 spikes in 0.03 s | < 2 spikes in 0.03 s | < 2 spikes in 0.03 s | 486.64 | nan | nan | nan | nan | 1182 nA |
| n3_busload_10n | sch | 9.32 | 9.34 | 7.19 | 5.56 | 1.00 | 1.00 | 1.20 | 0.14 | 1435 nA |
| n3_busload_10p | sch | < 2 spikes in 0.02 s | < 2 spikes in 0.02 s | < 2 spikes in 0.02 s | 2287.44 | nan | nan | nan | nan | 1350 nA |
| n3_busload_1n | sch | 9.32 | 9.35 | 7.20 | 54.85 | nan | nan | nan | nan | 1384 nA |
| n3_busload_30p | sch | < 2 spikes in 0.02 s | < 2 spikes in 0.02 s | < 2 spikes in 0.02 s | 1255.40 | nan | nan | nan | nan | 1257 nA |
| n3_c20p_0 | sch | < 2 spikes in 0.02 s | < 2 spikes in 0.02 s | < 2 spikes in 0.02 s | 214.85 | nan | nan | nan | nan | 1038 nA |
| n3_c20p_15 | sch | < 2 spikes in 0.02 s | < 2 spikes in 0.02 s | < 2 spikes in 0.02 s | 4101.45 | nan | nan | nan | nan | 1415 nA |
| n3_pad_0 | sch | < 2 spikes in 0.02 s | < 2 spikes in 0.02 s | < 2 spikes in 0.02 s | 209.21 | nan | nan | nan | nan | 1054 nA |
| n3_pad_15 | sch | < 2 spikes in 0.02 s | < 2 spikes in 0.02 s | < 2 spikes in 0.02 s | 4070.21 | nan | nan | nan | nan | 1415 nA |
| n3_pad_blink_6 | sch | 9.32 | 9.34 | 7.19 | 5.54 | 1.00 | 1.00 | 1.20 | 0.14 | 1439 nA |
| n3_tune_0 | sch | < 2 spikes in 0.02 s | < 2 spikes in 0.02 s | < 2 spikes in 0.02 s | 470.04 | nan | nan | nan | nan | 1380 nA |
| n3_tune_12 | sch | < 2 spikes in 0.02 s | < 2 spikes in 0.02 s | < 2 spikes in 0.02 s | 7254.78 | nan | nan | nan | nan | 1572 nA |
| n3_tune_15 | sch | < 2 spikes in 0.02 s | < 2 spikes in 0.02 s | < 2 spikes in 0.02 s | 8924.50 | nan | nan | nan | nan | 1614 nA |
| n3_tune_3 | sch | < 2 spikes in 0.02 s | < 2 spikes in 0.02 s | < 2 spikes in 0.02 s | 2185.31 | nan | nan | nan | nan | 1405 nA |
| n3_tune_6 | sch | < 2 spikes in 0.02 s | < 2 spikes in 0.02 s | < 2 spikes in 0.02 s | 3882.74 | nan | nan | nan | nan | 1465 nA |
| n3_tune_9 | sch | < 2 spikes in 0.02 s | < 2 spikes in 0.02 s | < 2 spikes in 0.02 s | 5572.95 | nan | nan | nan | nan | 1519 nA |
| syn01_both | sch | 13.21 | 9.91 | 0.91 | < 2 spikes in 2.5 s | 1.32 | 0.24 | nan | nan | 1123 nA |
| syn01_none | sch | 13.21 | 2.65 | 0.91 | < 2 spikes in 2.5 s | 4.83 | 0.60 | nan | nan | 950 nA |
| syn01_strong | sch | 13.21 | 7.08 | 0.91 | < 2 spikes in 2.5 s | 1.81 | 0.91 | nan | nan | 1061 nA |
| syn01_weak | sch | 13.21 | 4.07 | 0.91 | < 2 spikes in 2.5 s | 3.22 | 0.07 | nan | nan | 980 nA |
| tune_0_1_2_3 | sch | 1.19 | 2.60 | 3.06 | 3.12 | nan | nan | 1.00 | 0.98 | 1265 nA |
| tune_12_13_14_15 | sch | 17.01 | 18.32 | 15.07 | 12.84 | 0.93 | 0.07 | 1.14 | 0.06 | 1507 nA |
| tune_4_5_6_7 | sch | 6.67 | 8.02 | 7.19 | 6.37 | 0.83 | 0.05 | 1.07 | 0.16 | 1388 nA |
| tune_8_9_10_11 | sch | 11.95 | 13.23 | 11.18 | 9.61 | 0.87 | 0.10 | 1.14 | 0.08 | 1465 nA |
| tune_low | sch | 1.19 | 1.19 | 0.91 | 0.67 | 1.00 | 1.00 | 1.33 | 0.44 | 1139 nA |
| vcplb_0.0 | sch | 9.32 | 9.34 | 9.33 | 599.23 | 1.00 | 1.00 | 0.02 | 0.00 | 1613 nA |
| vcplb_0.8 | sch | 9.33 | 9.34 | 2.95 | 1.62 | 1.00 | 1.00 | 1.75 | 0.62 | 368 nA |
| vcplb_1.2 | sch | 9.32 | 9.34 | 2.21 | 0.87 | 1.00 | 1.00 | 2.50 | 1.00 | 497 nA |
| vcplb_3.3 | sch | 9.33 | 9.34 | 2.19 | < 2 spikes in 2.5 s | 1.00 | 1.00 | nan | nan | 953 nA |
| bus23_off | pex | < 2 spikes in 1.5 s | < 2 spikes in 1.5 s | 5.97 | 6.37 | nan | nan | 0.88 | 0.78 | 1330 nA |
| bus23_strong | pex | < 2 spikes in 1.5 s | < 2 spikes in 1.5 s | 8.74 | 8.74 | nan | nan | 1.00 | 1.00 | 444 nA |
| busload_0p | pex | 9.32 | 9.34 | 6.95 | 5.56 | 1.00 | 1.00 | 1.14 | 0.19 | 1431 nA |
| busload_100p | pex | 9.02 | 9.03 | 0.83 | 5.56 | 1.00 | 1.00 | 0.14 | 0.03 | 1389 nA |
| busload_10p | pex | 9.02 | 9.05 | 4.01 | 5.56 | 0.89 | 1.00 | 0.60 | 0.21 | 1372 nA |
| busload_30p | pex | 9.03 | 9.04 | 2.17 | 5.56 | 1.00 | 1.00 | 0.43 | 0.03 | 1420 nA |
| gap_both | pex | < 2 spikes in 1.5 s | 9.08 | < 2 spikes in 1.5 s | < 2 spikes in 1.5 s | nan | nan | nan | nan | 1404 nA |
| gap_off | pex | 7.70 | 10.26 | < 2 spikes in 1.5 s | < 2 spikes in 1.5 s | 0.75 | 0.08 | nan | nan | 1440 nA |
| n3_blink_15 | pex | 9.02 | 9.06 | 6.94 | 12.88 | 1.00 | 1.00 | 0.44 | 0.11 | 1496 nA |
| n3_busload_0p | pex | < 2 spikes in 0.02 s | < 2 spikes in 0.02 s | < 2 spikes in 0.02 s | 3792.23 | nan | nan | nan | nan | 1453 nA |
| n3_busload_100p | pex | < 2 spikes in 0.03 s | < 2 spikes in 0.03 s | < 2 spikes in 0.03 s | 485.14 | nan | nan | nan | nan | 1164 nA |
| n3_busload_1n | pex | 8.96 | 9.00 | 6.96 | 54.83 | nan | nan | nan | nan | 1408 nA |
| n3_pad_0 | pex | < 2 spikes in 0.02 s | < 2 spikes in 0.02 s | < 2 spikes in 0.02 s | 207.27 | nan | nan | nan | nan | 1052 nA |
| n3_tune_0 | pex | < 2 spikes in 0.02 s | < 2 spikes in 0.02 s | < 2 spikes in 0.02 s | 460.28 | nan | nan | nan | nan | 1275 nA |
| n3_tune_15 | pex | < 2 spikes in 0.02 s | < 2 spikes in 0.02 s | < 2 spikes in 0.02 s | 8688.82 | nan | nan | nan | nan | 1648 nA |
| n3_tune_6 | pex | < 2 spikes in 0.02 s | < 2 spikes in 0.02 s | < 2 spikes in 0.02 s | 3792.23 | nan | nan | nan | nan | 1453 nA |
| syn01_both | pex | 12.68 | 9.47 | < 2 spikes in 1.5 s | < 2 spikes in 1.5 s | 1.33 | 0.15 | nan | nan | 1641 nA |
| tune_0_1_2_3 | pex | < 2 spikes in 1.5 s | 2.50 | 2.95 | 3.12 | nan | nan | 1.00 | 0.96 | 1235 nA |
| tune_12_13_14_15 | pex | 16.39 | 17.62 | 14.56 | 12.87 | 0.90 | 0.22 | 1.06 | 0.08 | 1519 nA |
| tune_4_5_6_7 | pex | 6.43 | 7.73 | 6.94 | 6.37 | 0.89 | 0.23 | 1.00 | 0.46 | 1386 nA |
| tune_8_9_10_11 | pex | 11.48 | 12.74 | 10.80 | 9.61 | 0.88 | 0.23 | 1.08 | 0.22 | 1473 nA |

Rates in the table above: spikes after t0 / time (mean rate). Below and in tuning.png / busload.png: 1 / median interval, which ignores the rare spurious early spike of the transient solver.

Bus-capacitance sensitivity (code 6; C_bus = 3 pF line + external load). N2: pA neuron, N3: nA neuron (bbl_neuron_hi). Exponent: slope of ln f vs ln(10 pF + C_bus), fitted up to 10 nF (at 100 nF N3 does not reset its bus completely); -1 means f is inversely proportional to the membrane capacitance including the bus.

| tag | neuron | f (Hz) at C_bus (pF) | exponent |
|---|---|---|---|
| sch | N2 | 7.19 @ 3, 4.089 @ 13, 2.195 @ 33, 0.8371 @ 103 | -0.99 |
| sch | N3 | 3880 @ 3, 2286 @ 13, 1255 @ 33, 486.6 @ 103, 54.85 @ 1003, 5.555 @ 10003, 0.6417 @ 100003 | -0.99 |
| pex | N2 | 6.958 @ 3, 4.01 @ 13, 2.173 @ 33, 0.8334 @ 103 | -0.98 |
| pex | N3 | 3789 @ 3, 485.1 @ 103, 54.83 @ 1003 | -0.97 |

N3 alone (n3_* cases): rate (1 / median interval), swing of analog_bus3 after t0, supply current of the slot.

| case | tag | code | C on bus3 | pad leakage | f N3 (Hz) | bus3 min .. max (V) | I(vdd) avg |
|---|---|---|---|---|---|---|---|
| n3_blink_0 | sch | 0 | 10000 pF |  | 0.6716 | -0.00 .. 0.92 | 1281 nA |
| n3_blink_15 | sch | 15 | 10000 pF |  | 12.84 | 0.00 .. 0.92 | 1480 nA |
| n3_busload_0p | sch | 6 | 3 pF |  | 3880 | -0.00 .. 0.92 | 1465 nA |
| n3_busload_100n | sch | 6 | 100003 pF |  | 0.6417 | 0.11 .. 0.92 | 1457 nA |
| n3_busload_100p | sch | 6 | 103 pF |  | 486.6 | -0.00 .. 0.92 | 1182 nA |
| n3_busload_10n | sch | 6 | 10003 pF |  | 5.555 | -0.00 .. 0.92 | 1435 nA |
| n3_busload_10p | sch | 6 | 13 pF |  | 2286 | -0.00 .. 0.92 | 1350 nA |
| n3_busload_1n | sch | 6 | 1003 pF |  | 54.85 | -0.00 .. 0.92 | 1384 nA |
| n3_busload_30p | sch | 6 | 33 pF |  | 1255 | -0.00 .. 0.92 | 1257 nA |
| n3_c20p_0 | sch | 0 | 20 pF |  | 214.9 | -0.00 .. 0.92 | 1038 nA |
| n3_c20p_15 | sch | 15 | 20 pF |  | 4092 | -0.00 .. 0.92 | 1415 nA |
| n3_pad_0 | sch | 0 | 20 pF | yes | 209.2 | -0.00 .. 0.92 | 1054 nA |
| n3_pad_15 | sch | 15 | 20 pF | yes | 4061 | -0.00 .. 0.92 | 1415 nA |
| n3_pad_blink_6 | sch | 6 | 10000 pF | yes | 5.543 | -0.00 .. 0.92 | 1439 nA |
| n3_tune_0 | sch | 0 | 3 pF |  | 469.2 | -0.00 .. 0.92 | 1380 nA |
| n3_tune_12 | sch | 12 | 3 pF |  | 7247 | -0.00 .. 0.92 | 1572 nA |
| n3_tune_15 | sch | 15 | 3 pF |  | 8916 | -0.00 .. 0.92 | 1614 nA |
| n3_tune_3 | sch | 3 | 3 pF |  | 2184 | -0.00 .. 0.92 | 1405 nA |
| n3_tune_6 | sch | 6 | 3 pF |  | 3880 | -0.00 .. 0.92 | 1465 nA |
| n3_tune_9 | sch | 9 | 3 pF |  | 5569 | -0.00 .. 0.92 | 1519 nA |
| n3_blink_15 | pex | 15 | 10000 pF |  | 12.87 | 0.00 .. 0.92 | 1496 nA |
| n3_busload_0p | pex | 6 | 3 pF |  | 3789 | -0.00 .. 0.92 | 1453 nA |
| n3_busload_100p | pex | 6 | 103 pF |  | 485.1 | -0.00 .. 0.92 | 1164 nA |
| n3_busload_1n | pex | 6 | 1003 pF |  | 54.83 | -0.00 .. 0.92 | 1408 nA |
| n3_pad_0 | pex | 0 | 20 pF | yes | 207.3 | -0.00 .. 0.92 | 1052 nA |
| n3_tune_0 | pex | 0 | 3 pF |  | 459.2 | -0.00 .. 0.92 | 1275 nA |
| n3_tune_15 | pex | 15 | 3 pF |  | 8682 | -0.00 .. 0.92 | 1648 nA |
| n3_tune_6 | pex | 6 | 3 pF |  | 3789 | -0.00 .. 0.92 | 1453 nA |
