tatzelbrumm/bionicblinkenlights_chipalooza/testbenches/ngspice/results/bus23_pex.png

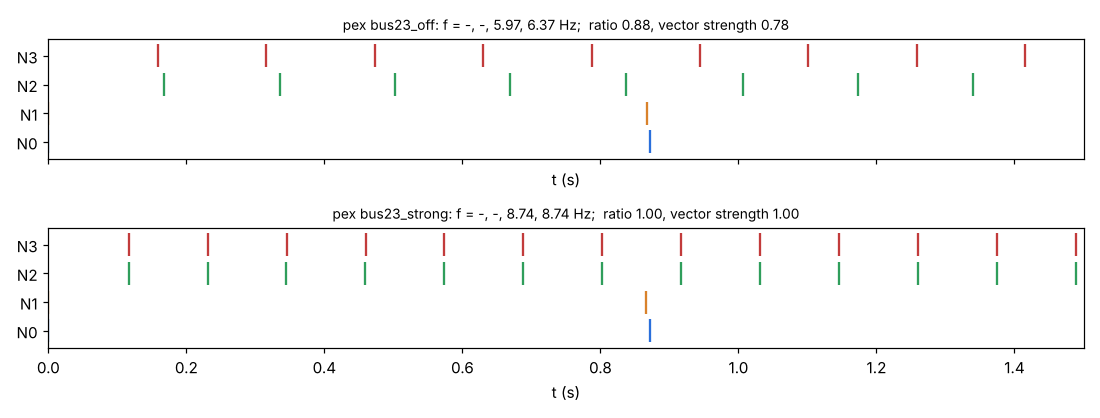
testbenches/ngspice/results/bus23_pex.png
