tatzelbrumm/bionicblinkenlights_chipalooza/testbenches/ngspice/results/bus23_sch.png

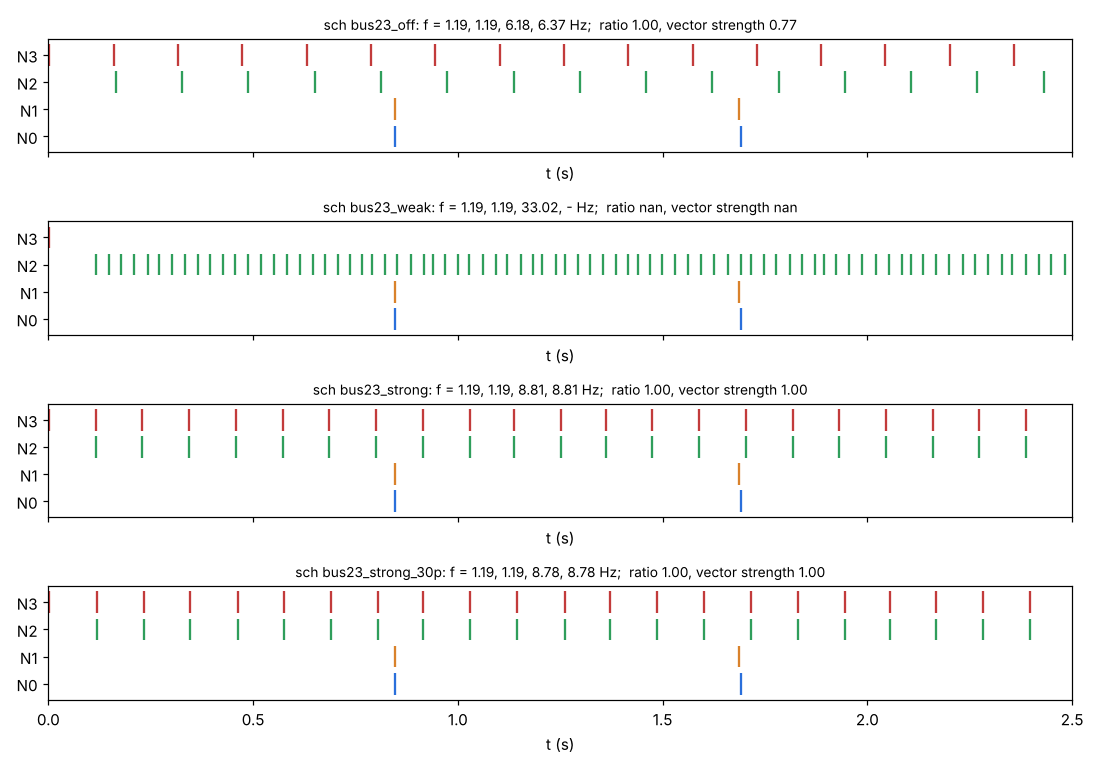
testbenches/ngspice/results/bus23_sch.png
