tatzelbrumm/bionicblinkenlights_chipalooza/testbenches/ngspice/results/busload.png

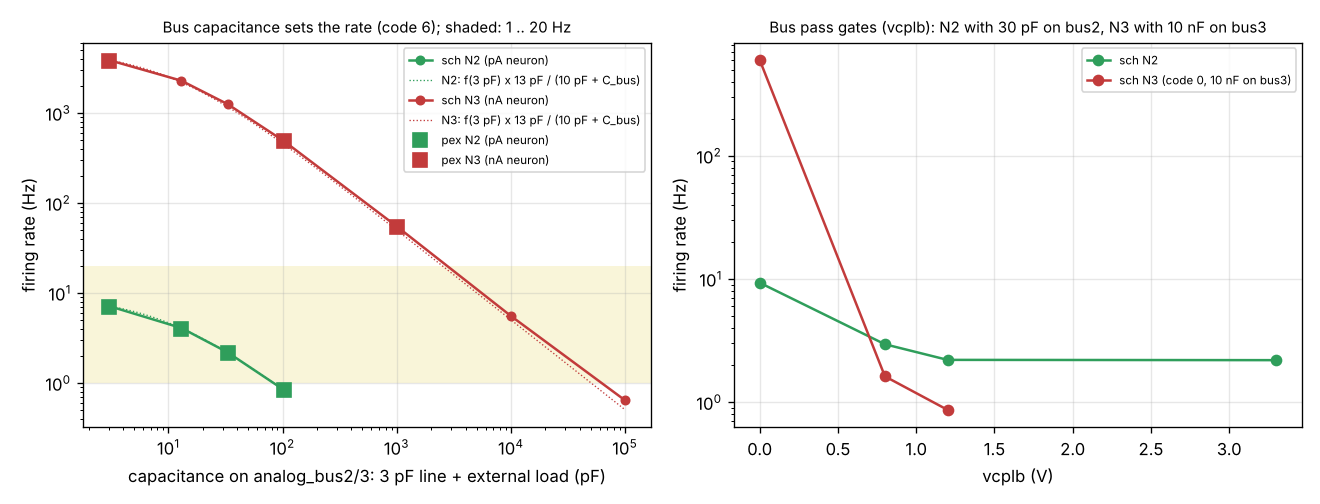
testbenches/ngspice/results/busload.png
