tatzelbrumm/bionicblinkenlights_chipalooza/testbenches/ngspice/results/gap_pex.png

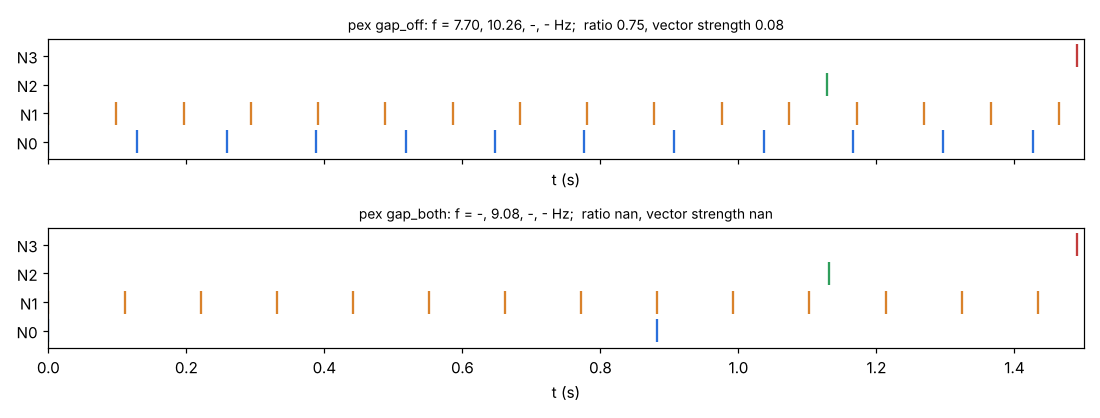
testbenches/ngspice/results/gap_pex.png
