tatzelbrumm/bionicblinkenlights_chipalooza/testbenches/ngspice/results/gap_sch.png

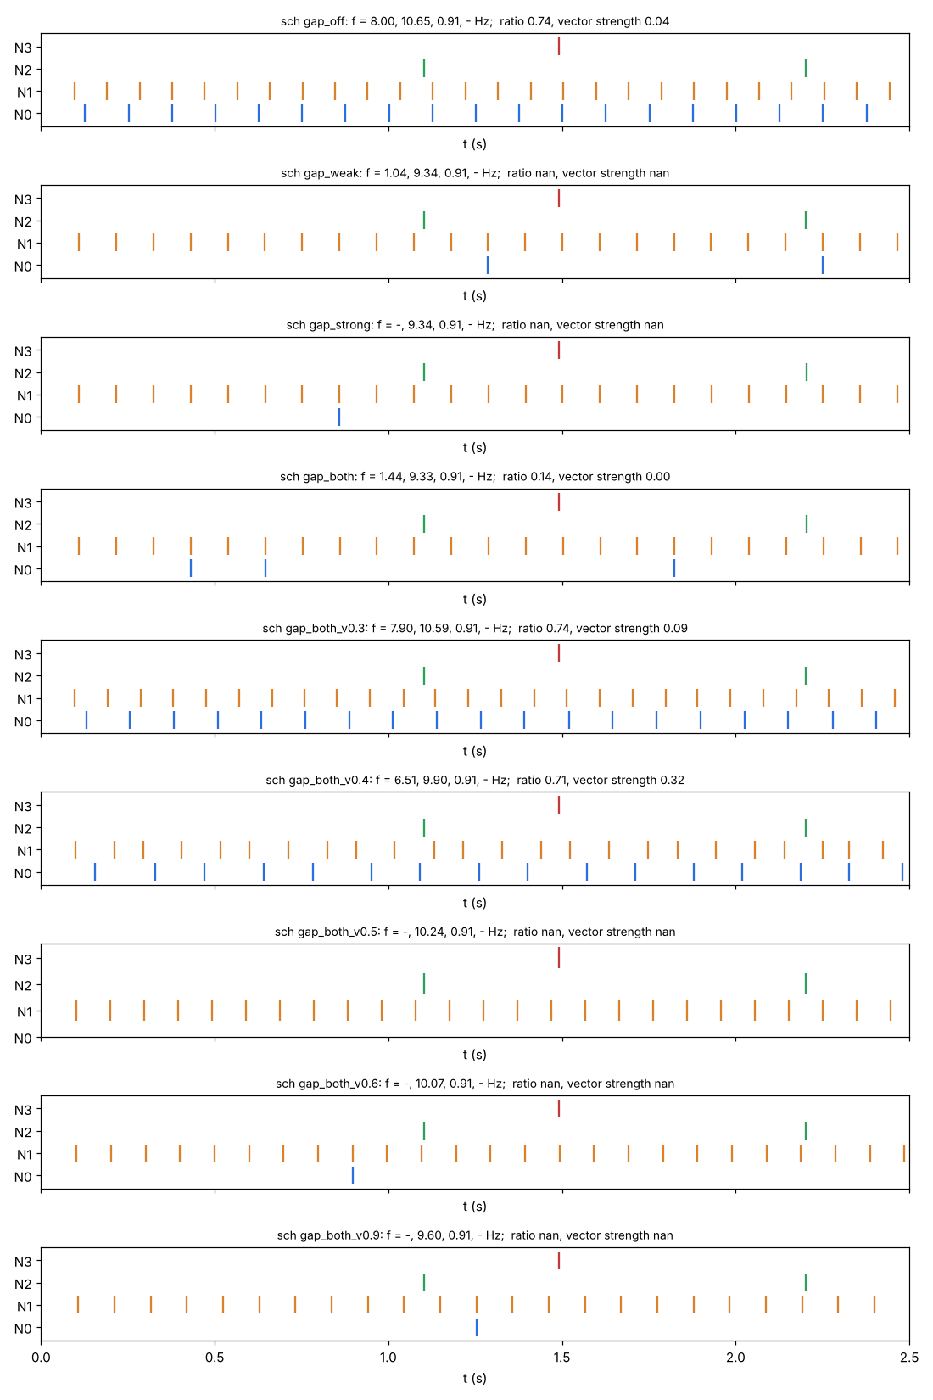
testbenches/ngspice/results/gap_sch.png
