tatzelbrumm/bionicblinkenlights_chipalooza/testbenches/ngspice/results/mutual_sch.png

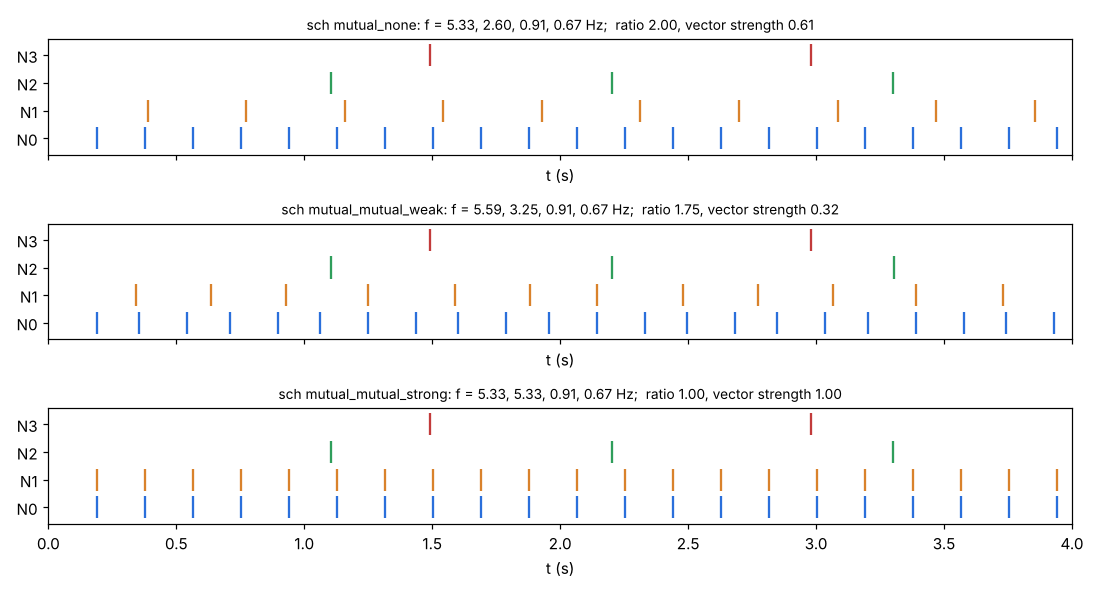
testbenches/ngspice/results/mutual_sch.png
