tatzelbrumm/bionicblinkenlights_chipalooza/testbenches/ngspice/results/syn01_pex.png

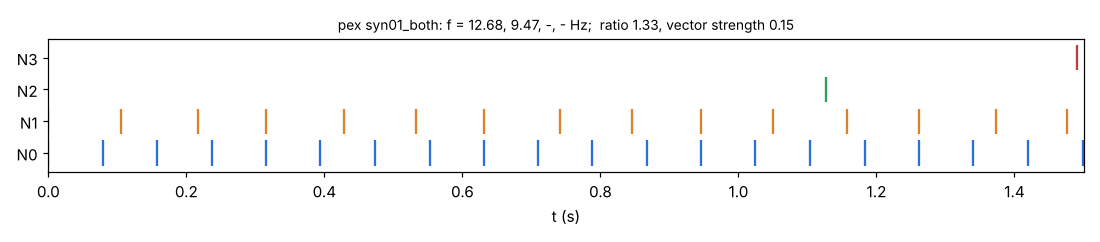
testbenches/ngspice/results/syn01_pex.png
