tatzelbrumm/bionicblinkenlights_chipalooza/testbenches/ngspice/results/syn01_sch.png

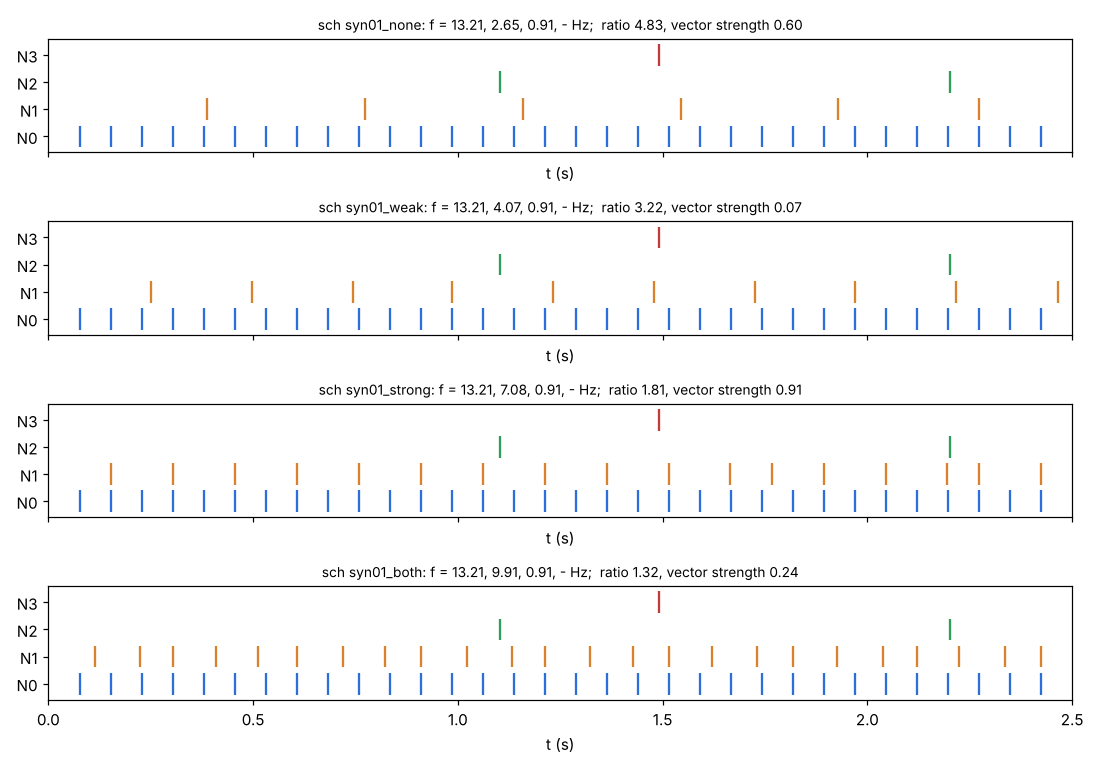
testbenches/ngspice/results/syn01_sch.png
