tatzelbrumm/bionicblinkenlights_chipalooza/testbenches/ngspice/results/tuning.png

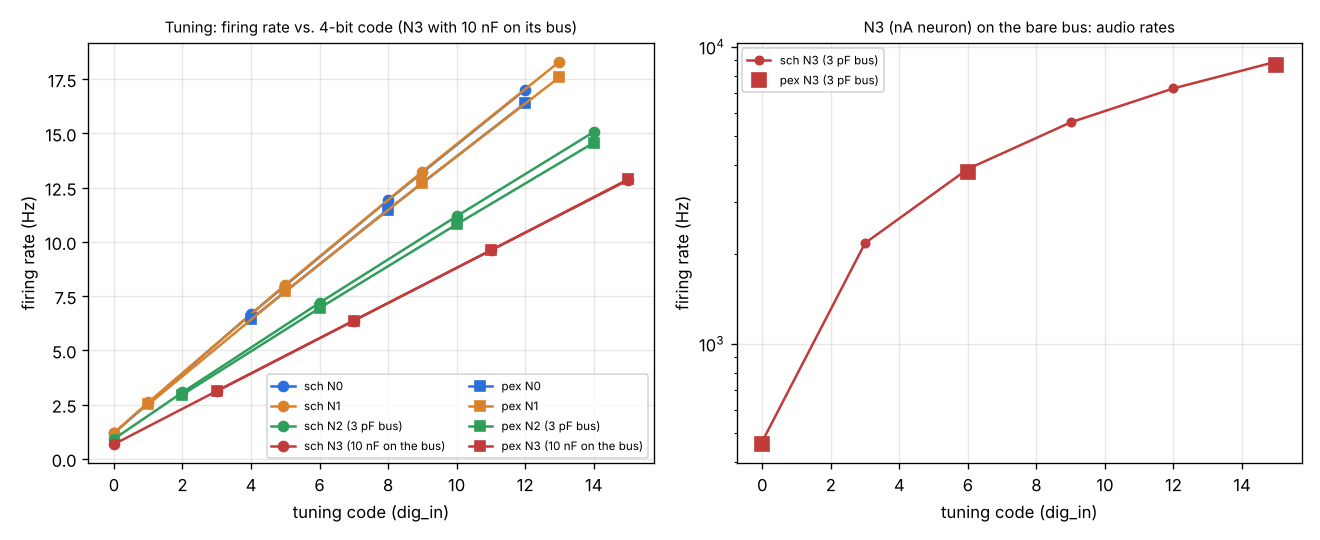
testbenches/ngspice/results/tuning.png
