tatzelbrumm/bionicblinkenlights_chipalooza/netlist/pex/bbl_slot_shared.pex.spice

*********************************************************
*** NGSPICE file created by KLayout-PEX 0.6.8
*** -----------------------------------------------------
***     Extraction Engine: KPEX/2.5D
***     Technology: ihp_sg13cmos5l
***     Date: 2026-11-09 12:13:11
*********************************************************

.SUBCKT bbl_slot_shared \$14.sa \$14.vbn \$14.vbp analog_bus0 analog_bus1
+ analog_bus2 analog_bus3 dig_in[0] dig_in[10] dig_in[11] dig_in[12] dig_in[13]
+ dig_in[14] dig_in[15] dig_in[16] dig_in[17] dig_in[18] dig_in[19] dig_in[1]
+ dig_in[20] dig_in[21] dig_in[22] dig_in[23] dig_in[2] dig_in[3] dig_in[4]
+ dig_in[5] dig_in[6] dig_in[7] dig_in[8] dig_in[9] dig_out[0] dig_out[10]
+ dig_out[11] dig_out[1] dig_out[2] dig_out[3] dig_out[4] dig_out[5] dig_out[6]
+ dig_out[7] dig_out[8] dig_out[9] enable sub! vbias vdd_1v2 vdd_3v3 vss_1v2
+ vss_3v3
X$1 dig_out[0] vss_3v3 vss_1v2 vdd_1v2 dig_out[2] dig_out[1] dig_out[7]
+ dig_out[6] dig_out[5] dig_out[4] dig_out[3] dig_out[10] dig_out[9] dig_out[8]
+ dig_out[11] sub! bbl_tielo
X$2 \$84 vdd_3v3 analog_bus0 vss_3v3 sub! bbl_inv
X$3 \$91 vdd_3v3 analog_bus1 vss_3v3 sub! bbl_inv
X$4 analog_bus2 vss_3v3 \$90 dig_in[22] dig_in[23] \$96 sub! bbl_gap
X$5 vss_3v3 \$89 \$86 dig_in[0] dig_in[1] dig_in[2] dig_in[3] vdd_3v3 \$84 sub!
+ bbl_unit
X$6 vss_3v3 \$95 \$86 dig_in[8] dig_in[9] dig_in[10] dig_in[11] vdd_3v3 \$92
+ sub! bbl_unit
X$7 vss_3v3 vdd_3v3 \$96 \$86 dig_in[12] dig_in[13] dig_in[14] dig_in[15] \$93
+ sub! bbl_unit_hi
X$8 vss_3v3 dig_in[16] dig_in[17] \$97 vdd_3v3 \$94 sub! bbl_syn
X$9 vss_3v3 dig_in[18] dig_in[19] \$98 vdd_3v3 \$89 sub! bbl_syn
X$10 \$89 vss_3v3 vbias dig_in[20] dig_in[21] \$94 sub! bbl_gap
X$11 vss_3v3 \$94 \$86 dig_in[4] dig_in[5] dig_in[6] dig_in[7] vdd_3v3 \$91
+ sub! bbl_unit
X$12 \$84 vdd_3v3 \$97 vss_3v3 sub! bbl_inv
X$13 \$91 vdd_3v3 \$98 vss_3v3 sub! bbl_inv
X$1 \$87 \$88 sub! rhigh w=5e-07 l=4.1055e-05 ps=1.8e-07 b=9 m=1
X$2 \$85 enable vss_1v2 sub! sg13_lv_nmos w=3e-07 l=5e-07 as=1.02e-13
+ ad=1.02e-13 ps=1.28e-06 pd=1.28e-06
X$3 \$85 enable vdd_1v2 \$I43 sg13_lv_pmos w=3e-07 l=5e-07 as=1.02e-13
+ ad=1.02e-13 ps=1.28e-06 pd=1.28e-06
X$4 vss_3v3 vbias vss_3v3 sub! sg13_hv_nmos w=1e-05 l=1e-05 as=3.4e-12
+ ad=1.9e-12 ps=2.068e-05 pd=1.038e-05
X$5 vss_3v3 vbias vss_3v3 sub! sg13_hv_nmos w=1e-05 l=1e-05 as=1.9e-12
+ ad=1.9e-12 ps=1.038e-05 pd=1.038e-05
X$6 vss_3v3 vbias vss_3v3 sub! sg13_hv_nmos w=1e-05 l=1e-05 as=1.9e-12
+ ad=1.9e-12 ps=1.038e-05 pd=1.038e-05
X$7 vss_3v3 vbias vss_3v3 sub! sg13_hv_nmos w=1e-05 l=1e-05 as=1.9e-12
+ ad=1.9e-12 ps=1.038e-05 pd=1.038e-05
X$8 vss_3v3 vbias vss_3v3 sub! sg13_hv_nmos w=1e-05 l=1e-05 as=1.9e-12
+ ad=3.4e-12 ps=1.038e-05 pd=2.068e-05
X$9 vss_3v3 \$90 vss_3v3 sub! sg13_hv_nmos w=1e-05 l=1e-05 as=3.4e-12
+ ad=1.9e-12 ps=2.068e-05 pd=1.038e-05
X$10 vss_3v3 \$90 vss_3v3 sub! sg13_hv_nmos w=1e-05 l=1e-05 as=1.9e-12
+ ad=1.9e-12 ps=1.038e-05 pd=1.038e-05
X$11 vss_3v3 \$90 vss_3v3 sub! sg13_hv_nmos w=1e-05 l=1e-05 as=1.9e-12
+ ad=1.9e-12 ps=1.038e-05 pd=1.038e-05
X$12 vss_3v3 \$90 vss_3v3 sub! sg13_hv_nmos w=1e-05 l=1e-05 as=1.9e-12
+ ad=1.9e-12 ps=1.038e-05 pd=1.038e-05
X$13 vss_3v3 \$90 vss_3v3 sub! sg13_hv_nmos w=1e-05 l=1e-05 as=1.9e-12
+ ad=3.4e-12 ps=1.038e-05 pd=2.068e-05
X$14 analog_bus2 \$90 \$95 sub! sg13_hv_nmos w=1e-06 l=4.5e-07 as=3.4e-13
+ ad=3.4e-13 ps=2.68e-06 pd=2.68e-06
X$15 \$14.sa enable vss_3v3 sub! sg13_hv_nmos w=1e-06 l=4.5e-07 as=3.4e-13
+ ad=3.4e-13 ps=2.68e-06 pd=2.68e-06
X$16 \$88 enable vss_3v3 sub! sg13_hv_nmos w=1e-06 l=4.5e-07 as=3.4e-13
+ ad=3.4e-13 ps=2.68e-06 pd=2.68e-06
X$17 \$14.vbn \$85 vss_3v3 sub! sg13_hv_nmos w=1e-06 l=4.5e-07 as=3.4e-13
+ ad=3.4e-13 ps=2.68e-06 pd=2.68e-06
X$18 \$14.vbp \$14.vbn \$87 sub! sg13_hv_nmos w=2e-06 l=2e-06 as=6.8e-13
+ ad=3.8e-13 ps=4.68e-06 pd=2.38e-06
X$19 \$87 \$14.vbn \$14.vbp sub! sg13_hv_nmos w=2e-06 l=2e-06 as=3.8e-13
+ ad=3.8e-13 ps=2.38e-06 pd=2.38e-06
X$20 \$14.vbp \$14.vbn \$87 sub! sg13_hv_nmos w=2e-06 l=2e-06 as=3.8e-13
+ ad=3.8e-13 ps=2.38e-06 pd=2.38e-06
X$21 \$87 \$14.vbn \$14.vbp sub! sg13_hv_nmos w=2e-06 l=2e-06 as=3.8e-13
+ ad=3.8e-13 ps=2.38e-06 pd=2.38e-06
X$22 \$14.vbp \$14.vbn \$87 sub! sg13_hv_nmos w=2e-06 l=2e-06 as=3.8e-13
+ ad=3.8e-13 ps=2.38e-06 pd=2.38e-06
X$23 \$87 \$14.vbn \$14.vbp sub! sg13_hv_nmos w=2e-06 l=2e-06 as=3.8e-13
+ ad=3.8e-13 ps=2.38e-06 pd=2.38e-06
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
Cext_8 \$14.sa \$I71 11.8691a
Cext_9 \$14.sa enable 672.111a
Cext_10 \$14.sa vbias 46.8545a
Cext_11 \$14.sa vdd_3v3 533.506a
Cext_12 \$14.sa vss_3v3 245.395a
Cext_13 \$14.sa sub! 650.082a
Cext_14 \$14.vbn \$14.vbp 4.02014f
Cext_15 \$14.vbn \$85 824.976a
Cext_16 \$14.vbn \$86 127.124a
Cext_17 \$14.vbn \$87 1.06006f
Cext_18 \$14.vbn \$88 92.7784a
Cext_19 \$14.vbn \$90 100.82a
Cext_20 \$14.vbn \$I71 872.947a
Cext_21 \$14.vbn enable 77.7407a
Cext_22 \$14.vbn vbias 122.647a
Cext_23 \$14.vbn vdd_1v2 1.5191a
Cext_24 \$14.vbn vdd_3v3 1.12839f
Cext_25 \$14.vbn vss_3v3 490.86a
Cext_26 \$14.vbn sub! 4.44136f
Cext_27 \$14.vbp \$85 709.067a
Cext_28 \$14.vbp \$86 368.97a
Cext_29 \$14.vbp \$87 524.973a
Cext_30 \$14.vbp \$88 103.262a
Cext_31 \$14.vbp \$90 208.016a
Cext_32 \$14.vbp \$I71 7.9824f
Cext_33 \$14.vbp enable 92.5787a
Cext_34 \$14.vbp vbias 214.119a
Cext_35 \$14.vbp vdd_3v3 1.01404f
Cext_36 \$14.vbp vss_3v3 158.249a
Cext_37 \$14.vbp sub! 3.18869f
Cext_38 \$18 \$86 1.50568a
Cext_39 \$18 \$93 1.24742f
Cext_40 \$18 \$96 220.429f
Cext_41 \$18 dig_in[12] 0.639689a
Cext_42 \$18 dig_in[13] 0.715954a
Cext_43 \$18 dig_in[14] 0.804589a
Cext_44 \$18 dig_in[15] 27.9186a
Cext_45 \$18 outb 730.978a
Cext_46 \$18 rst 113.204a
Cext_47 \$18 s0 20.471a
Cext_48 \$18 s1 35.8109a
Cext_49 \$18 s2 59.7397a
Cext_50 \$18 s3 123.364a
Cext_51 \$18 slow 1.71743f
Cext_52 \$18 vdd_3v3 19.0019f
Cext_53 \$18 vin 18.5895f
Cext_54 \$18 vss_3v3 3.23516f
Cext_55 \$19 \$89 160.327a
Cext_56 \$19 \$94 334.772a
Cext_57 \$19 \$97 374.308a
Cext_58 \$19 \$98 335.608a
Cext_59 \$19 analog_bus0 618.799a
Cext_60 \$19 bs 25.8706a
Cext_61 \$19 bw 72.8405a
Cext_62 \$19 dig_in[16] 28.0659a
Cext_63 \$19 dig_in[17] 164.366a
Cext_64 \$19 dig_in[18] 15.0979a
Cext_65 \$19 dig_in[19] 136.061a
Cext_66 \$19 gs 9.94849f
Cext_67 \$19 gw 30.3705f
Cext_68 \$19 vdd_1v2 2.13312f
Cext_69 \$19 vdd_3v3 18.8237f
Cext_70 \$19 vss_3v3 12.9346f
Cext_71 \$238 analog_bus0 2.75322a
Cext_72 \$238 analog_bus1 0.230404a
Cext_73 \$238 analog_bus2 0.154122a
Cext_74 \$238 analog_bus3 0.109718a
Cext_75 \$238 clk 10.6138a
Cext_76 \$238 vbias 127.725a
Cext_77 \$238 vss_1v2 48.765a
Cext_78 \$238 sub! 68.1424a
Cext_79 \$239 analog_bus0 2.75322a
Cext_80 \$239 analog_bus1 0.230404a
Cext_81 \$239 analog_bus2 0.154122a
Cext_82 \$239 analog_bus3 0.109718a
Cext_83 \$239 ibias0 127.725a
Cext_84 \$239 vbias 127.725a
Cext_85 \$239 vss_1v2 9.16252a
Cext_86 \$239 sub! 31.9a
Cext_87 \$241 analog_bus0 2.75322a
Cext_88 \$241 analog_bus1 0.230404a
Cext_89 \$241 analog_bus2 0.154122a
Cext_90 \$241 analog_bus3 0.109718a
Cext_91 \$241 ibias0 127.725a
Cext_92 \$241 ibias1 127.725a
Cext_93 \$241 vss_1v2 2.79293a
Cext_94 \$241 sub! 31.9a
Cext_95 \$243 analog_bus0 2.75322a
Cext_96 \$243 analog_bus1 0.230404a
Cext_97 \$243 analog_bus2 0.154122a
Cext_98 \$243 analog_bus3 127.835a
Cext_99 \$243 ibias1 127.725a
Cext_100 \$243 vss_1v2 1.07212a
Cext_101 \$243 sub! 31.9a
Cext_102 \$246 analog_bus0 2.75322a
Cext_103 \$246 analog_bus1 127.956a
Cext_104 \$246 analog_bus2 127.725a
Cext_105 \$246 vss_3v3 1.47958a
Cext_106 \$246 sub! 31.9a
Cext_107 \$247 analog_bus0 2.75322a
Cext_108 \$247 analog_bus1 0.230404a
Cext_109 \$247 analog_bus2 127.88a
Cext_110 \$247 analog_bus3 127.725a
Cext_111 \$247 vss_3v3 0.244588a
Cext_112 \$247 sub! 31.9a
Cext_113 \$248 analog_bus0 130.479a
Cext_114 \$248 analog_bus1 127.725a
Cext_115 \$248 vss_3v3 4.25665a
Cext_116 \$248 sub! 31.9a
Cext_117 \$249 analog_bus0 127.725a
Cext_118 \$249 vss_3v3 59.9549a
Cext_119 \$249 sub! 89.9303a
Cext_120 \$30 \$84 803.081a
Cext_121 \$30 \$86 689.314a
Cext_122 \$30 \$89 220.381f
Cext_123 \$30 \$91 877.425a
Cext_124 \$30 \$92 991.493a
Cext_125 \$30 \$93 611.305a
Cext_126 \$30 \$94 220.455f
Cext_127 \$30 \$95 220.567f
Cext_128 \$30 \$96 1.5176f
Cext_129 \$30 dig_in[0] 1.01283a
Cext_130 \$30 dig_in[10] 389.584a
Cext_131 \$30 dig_in[11] 193.638a
Cext_132 \$30 dig_in[12] 478.429a
Cext_133 \$30 dig_in[13] 219.766a
Cext_134 \$30 dig_in[14] 222.145a
Cext_135 \$30 dig_in[15] 644.127a
Cext_136 \$30 dig_in[1] 1.38142a
Cext_137 \$30 dig_in[2] 1.58673a
Cext_138 \$30 dig_in[3] 43.4706a
Cext_139 \$30 dig_in[4] 75.5899a
Cext_140 \$30 dig_in[5] 75.9122a
Cext_141 \$30 dig_in[6] 76.9499a
Cext_142 \$30 dig_in[7] 119.262a
Cext_143 \$30 dig_in[8] 300.9a
Cext_144 \$30 dig_in[9] 187.961a
Cext_145 \$30 rst 2.17287f
Cext_146 \$30 s0 61.4129a
Cext_147 \$30 s1 94.4657a
Cext_148 \$30 s2 618.55a
Cext_149 \$30 s3 1.11532f
Cext_150 \$30 slow 2.98064f
Cext_151 \$30 vdd_3v3 59.8081f
Cext_152 \$30 vin 21.4774f
Cext_153 \$30 vss_3v3 19.9763f
Cext_154 \$5 \$84 766.087a
Cext_155 \$5 \$91 768.118a
Cext_156 \$5 \$97 194.267a
Cext_157 \$5 \$98 179.151a
Cext_158 \$5 analog_bus0 116.231a
Cext_159 \$5 analog_bus1 116.171a
Cext_160 \$5 dig_in[21] 1.70665a
Cext_161 \$5 gw 4.98097a
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
Cext_671 \$92 rst 252.686a
Cext_672 \$92 s0 29.5112a
Cext_673 \$92 s1 48.3755a
Cext_674 \$92 s2 498.672a
Cext_675 \$92 s3 166.535a
Cext_676 \$92 slow 94.039a
Cext_677 \$92 vbias 0.25014a
Cext_678 \$92 vdd_3v3 3.53105f
Cext_679 \$92 vin 249.943a
Cext_680 \$92 vss_1v2 105.222a
Cext_681 \$92 vss_3v3 581.508a
Cext_682 \$92 sub! 3.25529f
Cext_683 \$93 \$94 12.7056a
Cext_684 \$93 \$95 15.5744a
Cext_685 \$93 \$96 19.9196f
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
