tatzelbrumm/bionicblinkenlights_chipalooza/(commit log)

2026-11-08 Bionic Blinkenlights slot: source netlist, layout generator, DRC/LVS-clean slot layouts
    Self-biased CMOS translation of the 4-transistor Bionic Blinkenlights neuron
    (sg13_hv devices), tuning DAC, pulse synapses, gap junctions, bus coupling,
    beta-multiplier reference. Two slot variants (shared pins only; two
    dedicated analog pads). KLayout DRC (no density) 0 violations, KLayout LVS
    (deep, no tap extraction) match for both.
    Claude-Session: https://claude.ai/code/session_01XU3KHA7Yq8zX5MgXJUhmLH
2026-11-08 xschem sheets with round-trip check, PEX netlists, slot_N generation
    Generated sheets and symbols for every subcircuit and both slot tops plus a
    slot testbench; check_sheets.py netlists each sheet with xschem and compares
    device by device with the source netlist (0 mismatches). kpex 2.5D (CC)
    extraction of both slot variants. build_slot.py / mkcdl.py produce
    slot_<N>.gds and its CDL for any slot (slot_18 pads variant: LVS match).
    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
    [bbl_bias.sch, bbl_core.sch, bbl_dac.sch, bbl_gap.sch, bbl_inv.sch, bbl_neuron.sch, bbl_slot_pads.sch, bbl_slot_shared.sch]
2026-11-09 Current-limited M3 (R4), larger C2; final DRC/LVS/PEX reports, README, run log
    XM3 0.3/4 um limits the regenerative current to about 8 uA, like R4 of the
    discrete circuit; this also removes the simulator's spurious second solution
    that made neurons fire through disabled gap junctions. C2 2.6 pF. Both slot
    variants rebuilt: KLayout DRC 0 violations, LVS match, kpex 2.5D netlists.
    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
    [bbl_core.sch, bbl_neuron.sch, bbl_slot_pads.sch, bbl_slot_shared.sch, bbl_unit.sch]
2026-11-09 Neuron R5 split (fast discharge + slow recharge), final DRC/LVS/PEX
    With a heavily loaded bus the current-limited upstroke let the reset path
    engage at the same out level (stable intermediate state). R5 is now a
    self-biased NMOS (fast discharge of the slow node) plus a PMOS on the DAC
    bias (slow recharge = refractory time), like the long R5 C2 recovery of the
    original: complete resets at any bus load. Layout, sheets, LVS (match),
    DRC (0), kpex netlists updated.
    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
    [bbl_bias.sch, bbl_dac.sch, bbl_gap.sch, bbl_inv.sch, bbl_neuron.sch, bbl_syn.sch, bbl_tielo.sch]
2026-11-09 Recalibrate tuning DAC to 1..21 Hz (XMLP 0.3/7, XMH 0.3/3.2)
    Code 0 fired at 0.3 Hz and code 15 at about 18 Hz; the DAC reference is
    14 % higher and the always-on base leg 0.75 unit. Layouts rebuilt, LVS
    match for both slot variants.
    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
2026-11-09 Final DRC (0 violations), LVS logs, kpex netlists of the recalibrated slots
    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
2026-11-09 bbl_neuron sheet: hand redraw in progress (check_sheets.py OK)
    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
    [bbl_neuron.sch]
2026-11-09 Work in progress (automatic commit while the simulations run)
    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
    [bbl_syn.sch]
2026-11-09 plots.py: firing rate vs bus capacitance (log-log, 1/C prediction, exponent table); tune_low; runs with fewer than two spikes left out
    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
2026-11-09 Bus spike detector takes the fast upstroke; campaign.py --reanalyze; gap junction at vcpla 0.3/0.4/0.5 V; run log rows 59-64
    The 1.5 V level missed the spikes of bus-coupled membranes on a loaded bus (peak 1.16 V at 30 pF,
    0.90 V at 100 pF), so post-layout busload_30p/100p reported 0 Hz for N2, N3.
    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
2026-11-09 README: bus capacitance result, bus pulse heights, supply current, tuning law, spike detection; SUMMARY draft
    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
2026-11-09 Post-layout bus-capacitance sweep complete (13 and 103 pF); summary, run log rows 69-70, figures, chat log
    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
2026-11-09 Slot 3: final/gds/slot_3.gds (pads variant), DRC and LVS; harness bus capacitance and leakage
    - build_slot.py ties a frame's second vss_3v3 pin (slots 3, 12: Metal2, right edge) to the ground
    straps and reads the dedicated pad types from the harness config.txt
    - netlist/cdl/bbl.cdl with the slot_3 top cell; bbltb.slot_dut maps the pins of any slot
    - final/gds holds only slot_3.gds; the generic variants stay in layout/gds
    - testbenches/harness_bus: the harness's extracted bus switch and the PDK analog pad (capacitance,
    leakage), N2/N3 with the pad's leakage on their buses
    - README (slot 3 and moving to another slot, harness bus), SUMMARY, run log rows 72-75, chat log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
2026-11-09 N3 robust against bus leakage (bbl_neuron_hi): design, schematics, layout, DRC, LVS, PEX
    N3 charges its membrane with 16 x the DAC current (5.6 .. 174 nA): audio rates on chip, blinking
    with about 10 nF on analog_bus3. Its comparator is a Schmitt trigger (inverter out -> outb, pull-up
    on out gated by outb) and its slow-node discharge a switch gated by outb, so that it oscillates and
    resets the bus fully from 3 pF to 100 nF. Layout, sheets, DRC (0), LVS (match) and kpex of slot_3
    and both generic variants; testbench and campaign updated. Simulation results follow.
    Claude-Session: https://claude.ai/code/session_01XU3KHA7Yq8zX5MgXJUhmLH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
    [bbl_core.sch, bbl_neuron_hi.sch, bbl_unit_hi.sch]
2026-11-09 Simulation results for the nA neuron N3; corrected currents, refractory time and 100 nF reset
    Schematic campaign (53 cases) and post-layout campaign on slot_3 (21 cases). N3 follows the 1/C law
    from 3 pF to 10 nF (exponent -0.99; 3.9 kHz on the bare bus, 5.6 Hz with 10 nF at code 6), as N2 does
    from 3 to 103 pF. With 100 nF N3's reset is incomplete (bus resets to 0.11 V, rate 15 % above the
    line); commit 252bc48 said it resets fully up to 100 nF, which holds up to 10 nF. The PDK pad's
    leakage slows N3 by 0.25 to 2.6 %. Weak N3 -> bus2 coupling: N2 fires at 33 Hz for N3, which stops;
    strong: 1:1 lock.
    Measured by DC sweeps and corrected in README, comments, sheet note and harness_bus/results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
    [bbl_neuron_hi.sch]
